bt-soft/nano-wallscout/README.md

# Pulzusindukciós (PI) betonvas-kereső – Arduino Nano + DD tekercs + MCP6004 + IRLZ44N + SSD1306

> [!NOTE]
> A projekt egy kézi impulzusindukciós (PI) elven működő - **mélységbecsléssel ellátott** - betonvas-kereső, amely két D alakú tekerccsel (DD elrendezés) működik. 
>
> Platform: **Arduino Nano (ATmega328P)**.

| Jellemző | Érték |
|---|---|
| Érzékelési mélység* | ≈5–6 cm, 8 cm becsült határeset (Ø8–12 mm betonvas, a tekercsek méretétől függően) |
| Kijelzés | SSD1306 OLED (oszlop, számérték, becsült mélység), hangjelzés |
| Tápellátás | 2S vagy 3S 18650 akkumulátor a Nano VIN bemenetén (lásd: Beüzemelés) |

 *Az értékek a tesztelési körülményektől, a tekercs geometriájától és a beállításoktól függnek.

## Az impulzusindukció működési elve
A kereső két tekercset használ: egy **adó (TX)** és egy **vevő (RX)** tekercset. A [tekercsek D alakúak](https://abl.gtu.edu.tr/dosya/102/~saksoy/Metal%20Detectors/1%20GENERAL%20OVERVIEW/2%20OPERATIONAL%20PRINCIPLES/2.1%20ANTENNAS.pdf), és az egyenes oldalaikkal részben egymásra vannak csúsztatva (DD elrendezés). Az alábbiak a működés fizikai alapjait foglalják össze.

### Az adóimpulzus és a mágneses tér
A Q2 kapcsolótranzisztor bekapcsolásakor az Ltx1 adótekercsre a tápfeszültség kerül, és az árama az induktivitás miatt lineárisan nő: `I ≈ U · t / L`. 12 V-nál, 60 µs-os impulzusnál és 1 mH-s tekercsnél ez elméletileg kb. 0,7 A; a tekercs ellenállása miatt a valós csúcsáram kb. 0,6 A. Az áram körül mágneses tér épül fel, amelynek energiája `E = ½ · L · I²`.

### Kikapcsolás és örvényáramok
A Q2 lezárásakor a mágneses tér gyorsan összeomlik. Ez a tekercsben nagy feszültségtüskét (flyback) okoz, amelyet a D2 és D3 diódák korlátoznak. A gyorsan változó tér a közelében lévő fémtárgyban **örvényáramot** indukál. Az örvényáram saját mágneses teret hoz létre, amely lecsengés közben visszahat a tekercsekre.

- Az örvényáram lecsengésének időállandója függ a tárgy méretétől, vezetőképességétől és mágneses permeabilitásától. A nagyobb, jobban vezető tárgynál a lecsengés hosszabb.
- A tárgy nélküli (levegős) esetben a tekercs saját tranziense gyorsan lecseng, ezért a rövid idő múlva mért jel gyakorlatilag nulla.
- A tárgy jelenléte így a lecsengés „farkában” mérhető többletjelként jelenik meg.

### A DD elrendezés és a közvetlen áthallás kioltása
Az [adó mágneses terének](doc/Fémkereső%20tekercsek%20betonvas%20kereséshez.png) közvetlenül az RX-be jutó része sokszorosan nagyobb lenne a fém jelénél. A két D alakú tekercs átfedésénél azonban a vevőtekercs két felét az adótér ellentétes irányban metszi, ezért a **kölcsönös induktivitás (M) a megfelelő átfedésnél nullára csökken**. A pontos átfedés a beállítási eljárás (DD beállító mód) feladata. A nullpont két oldalán M előjele ellentétes, ezért a beállításkor az előjelváltást kell keresni.

DD-tekercs

Ennek eredményeként fém jelenléte nélkül az RX tekercsre elsősorban a **maradék mágneses áthallás** és a **zaj** jut. Fém jelenlétében a benne indukálódó örvényáramok mágneses tere megváltoztatja a vevőtekercsben mérhető jelet. A megfelelően beállított DD-tekercspár esetén a fém nélküli alapjel alacsony, így a céltárgy által okozott jelváltozás jól érzékelhető.

A nagyobb tekercs megfelelő kialakítás esetén növelheti az érzékelési mélységet, de az elérhető eredmény a tekercsek geometriájától, induktivitásától, ellenállásától, a meghajtóáramtól és a vevő érzékenységétől is függ. A nagyobb tekercs térben kiterjedtebb érzékelési mezőt hozhat létre, ami ugyan növelheti a hatótávolságot, ugyanakkor ronthatja a céltárgy pontos helyének behatárolását.

A projektben alkalmazott, a kisebb 6 × 5 cm-es D alakú tekercspárral az érzékelési mélység körülbelül 5-6 cm. Ez az érték kísérletileg meghatározott (fémcsipeszt közelítve a tekercsek felé), illetve a mérési körülményektől és a céltárgy jellemzőitől függ.

### Jelfeldolgozás
Az Rx jele a mérendő tárgy hatására csak kis amplitúdójú, ezért az MCP6004 két, nem invertáló fokozata (kb. 11 × 11 = 121-szeres erősítés) erősíti, majd az U2D puffer az A0 bemenetre vezeti. A jelszint a Vmid (≈ 2,5 V) körül van, így a jel pozitív és negatív irányban is mérhető.

A mérés **mintavételes**, impulzusonként két ponton:
- **S1**: a kikapcsolás után 60 µs-mal. Ekkor a tárgy örvényárama még jelen van.
- **S2**: a kikapcsolás után 600 µs-mal. Ekkor az örvényáram lecsengett, így ez az alapvonal (offset, drift).

A **jel = S1 − S2**. A különbségképzés kiejti az egyenfeszültségű eltérést és a lassú driftet. 100 impulzus átlagolása a véletlenszerű zajt csökkenti (a zaj nagyjából az átlagolt minták számának négyzetgyökével csökken). A nullázáskor mért, fém nélküli értéket a firmware kivonja, így a megjelenített érték a tárgy hatását mutatja.

### Mélységbecslés
Kis, a tekercstől távoli tárgy esetén az örvényáram jele nagyjából a távolság harmadik hatványával csökken (dipól közelítés): `S ≈ K / d³`. A `K` értéket a kalibrálás határozza meg egy ismert (5 cm) távolságban, innen `d = ∛(K / S)`. Ez a modell a tárgy méretétől és anyagától függ, ezért a kapott érték becslés, nem pontos mérés.

### A fém típusa
Az impulzus utáni jel lecsengésének időbeli jellemzői elvileg információt hordozhatnak a céltárgy anyagáról. A jelenlegi, két időpontban történő mintavételezés és a hozzá tartozó jelfeldolgozás azonban nem biztosít megbízható anyagazonosítást, ezért ezt a funkciót eltávolítottam a firmware-ből.

## Működési ciklus

1. Az IRLZ44N (Q2) 60 µs-ra bekapcsol, a **Tx tekercs** (Ltx1) árama nő.
2. Kikapcsoláskor a flyback-tüskét a D2 (UF4007) és a D3 (ZPY36, 1 W) korlátozza; a névleges **lecsípési szint** nagyjából 37 V.
3. A tranziens lecsengését az Ltx1-gyel párhuzamos R15 + R16 ág (1 kΩ fix ellenállás + 4,7 kΩ-os trimmer) csillapítja. A fémben indukált örvényáram lassabban cseng le; ez a mérendő „farok”.
4. A **külön Rx tekercs** (Lrx1) az Ltx1-gyel DD elrendezésben (részben egymásra csúsztatva) helyezkedik el, így a közvetlen áthallás közel nulla, és az erősítőbe csak a fém által keltett jel jut.
5. A Nano 1 kHz-en ismétel, és impulzusonként két ponton mintavételez az ADC-vel: **S1** a kikapcsolás után 60 µs-mal, **S2** (alapvonal) 600 µs-mal.
6. Jel = S1 − S2, 100 impulzusra átlagolva (kb. 7 Hz kijelzőfrissítés). Ez kiejti az offsetet és a lassú driftet.
7. Indításkor automatikus nullázás történik (a kereső legyen levegőben). Az alapvonal lassan követi a driftet. Egy találat előjelét a firmware megtartja; az ellenkező előjelű kilengést csak 1 másodpercnyi küszöb alatti jel után kezdi új találatként kezelni. Ha a jel kb. 3 másodpercnél tovább állandó marad (pl. nullpont-eltolódás), a firmware lassan újranulláz; egy mozdulatlanul tartott fém így néhány másodperc után elhalkul.
8. A kijelző oszlopot, számértéket és (kalibrálás után) becsült mélységet mutat. A hangjelzés magassága a jellel nő.

### Szoftverműködés – bevezető

A firmware az időkritikus részeken az **AVR hardverregisztereket közvetlenül kezeli** (`PORTD`, `PIND`, `DDRD`, `TCNT1`, `TCCR1/2`, `ADCSRA`, `ADMUX`, `PCMSK2` stb.) az Arduino `digitalWrite`/`analogRead`-jellegű, lassabb és nagyobb kódú burkolófüggvényei helyett. Ez minimalizálja a kód méretét (a program a Nano 30 KB-os flash-ébe fér), és tartja a futási sebességet: a 60 µs-os adóimpulzus, a kikapcsolás utáni S1/S2 mintavétel (0,5 µs-os Timer1-időalap, gyors, 1 MHz-es ADC-órajel) és a hangjelző (Timer2 hardveres kimenet, CPU-terhelés nélkül) így determinisztikus időzítéssel fut.

### Alvó mód (energiatakarékosság)

Ha **5 percig** nincs aktivitás, a műszer a lehető legkisebb fogyasztású **Power-down** módba kapcsol. Aktivitásnak számít: gombnyomás, aktív találat, vagy a nullázás utáni zajküszöböt meghaladó jelváltozás (a zaj nem tartja ébren). Az időkorlát a `config.h` `IDLE_SLEEP_MS` értéke.

Alvás előtt a firmware kikapcsolja a hangjelzőt, az adókaput (az adó nem kap impulzust), az OLED-et (power save, I²C leállítva), az ADC-t és az analóg bemenetek digitális pufferét, a Brown-out detektort és a watchdogot, valamint az összes perifériát (`power_all_disable`).

Ébresztés: a **kalibráló vagy a nullázó gomb** megnyomásával (pin change megszakítás), illetve a tápfeszültség újrakapcsolásával. Ébredés után a készülék újrainicializálódik, megvárja a gomb felengedését (az ébresztő nyomás nem lesz parancs), majd az indításhoz hasonlóan újranulláz – ilyenkor a kereső legyen levegőben.

Megjegyzés: a vevő (erősítő) tápját a firmware nem tudja kapcsolni, mert nincs rá vezérlőláb; az adó viszont impulzus nélkül áramot nem vesz fel. A legkisebb alvóáramhoz a vevő és a kijelző tápja hardveresen is leválasztható egy későbbi fejlesztésben.

### Gombok

Mindkét gomb a D-lábat földre húzza (belső felhúzással). A gombokat a mérés közben is figyeli a firmware, de a művelet a következő kijelzőfrissítéskor (kb. 0,1–0,2 s) hajtódik végre.

**Arduino D5 – NULLÁZÁS / beállító mód**

| Művelet | Normál (kereső) módban | DD beállító módban |
|---|---|---|
| Rövid nyomás (< 1 s), **felengedéskor** lép életbe | Újranullázás: a kijelzőn `Nullazas - legben!`, kb. 15 mérésen át (≈ 2 s) átlagolja a nullpontot és a zajszintet (a küszöb a zajhoz igazodik). Közben a kereső legyen levegőben, és ne legyen jelzés/csipogás. | Kilép a beállító módból, és újranulláz. |
| Hosszú nyomás (≥ 1 s), **még nyomva tartva** lép életbe | Belép a DD beállító módba (a `min` törlődik). | Nincs külön szerepe: a felengedéskor ugyanúgy kilép és újranulláz, mint a rövid nyomás. |

A mód váltását rövid (150 ms-os), 3 kHz-es csipogás jelzi. A hosszú nyomás után a gomb felengedése már nem indít újabb műveletet.

**Arduino D4 – KALIBRÁLÁS / KÖZÉPKERESŐ / `min` törlése**

Normál kereső módban a D4 rövid megnyomásai a következő nézetek között léptetnek: normál keresés → élő `CENTER SCAN` → `Jel-Ido` grafikon → normál keresés. A grafikon folyamatosan gyűjti a méréseket: az amplitúdó jobbról érkezik, a korábbi minták balra gördülnek, így a jel erősségének időbeli alakulása követhető. A grafikon a nullázott jel abszolút értékét mutatja; a szaggatott vízszintes vonal az adaptív küszöb. A hosszú nyomás a távolságtanító képernyőt nyitja meg (lásd lent). DD beállító módban a D4 megnyomása törli a `min` értéket (eddigi legkisebb abszolút áthallás), és újra a következő mérésből indul.

Középkereső módban a kijelző az előjeles, nullázott jelet, annak rövid gördülő grafikonját, a zajküszöböt, az első és a visszapásztázás során mért csúcsot mutatja. A firmware legalább két küszöb feletti mintával jelöltet keres, több csökkenő minta alapján becsül csúcsot, majd visszapásztázás után a két csúcserősséget hasonlítja össze. A `CSUCS MEGEROSITVE` csak ezt a jelerősség-egyezést jelenti: a mintasorszám nem pozíció, így a mód nem mér és nem jelöl ki pontos fizikai középvonalat. A visszapásztázás irányát nem nevezi meg.

A mód bekapcsolásakor a mérő legyen levegőben és fémtől távol. Ha a `ZAJOS MERES` felirat látszik, válassz kevésbé zajos helyet és nullázz újra a D5 rövid megnyomásával. Középkereső módban a driftkövetés és az automatikus újranullázás szünetel, így a hosszan a tekercs alatt tartott tárgyat nem nyomja el a háttérkövetés. A visszalépéshez nyomd meg röviden újra a D4-et.

Normál módban:

1. Tartsd lenyomva a D4-et **1 másodpercig**: megnyílik a `TANITAS 5cm` képernyő, amely folyamatosan mutatja a vett jelet, egy oszlopot és (érvényes kalibráció esetén) a becsült távolságot. A képernyőn a driftkövetés szünetel.
2. Tarts egy vasat (a használt vastípust) pontosan **5 cm**-re a tekercstől, és nyomd meg röviden a D4-et. Ha a jel a küszöb fölött van, a firmware eltárolja a `K = jel · 5³` értéket (az `S ≈ K/d³` modellre), az **EEPROM**-ba menti (kikapcsolás után is megmarad), 3 kHz-es csipogás hallatszik, és 1,5 s-ig `Rogzitve: 5 cm` látszik. A képernyő nyitva marad, így a rögzítés tetszőleges számú alkalommal megismételhető, és a becsült távolság azonnal ellenőrizhető.
3. Ha nincs elég jel, a mentés **nem** történik meg: `Nincs jel!` (vagy túlvezérlésnél `Tulvezerles!`) jelenik meg. Hozd közelebb a vasat, és próbáld újra.
4. Kilépés: a D5 rövid megnyomása (újranullázás nélkül) vagy a D4 ismételt hosszú nyomása.
5. Nullázás közben (`Nullazas - legben!`) a tanítóképernyő nem nyitható meg.

Kalibrálás nélkül a kijelzőn `nincs kal.` látszik, és mélység nem jelenik meg.

Mélység: d = ∛(K/S). Ez a mélység becslése, nem pontos mérés.

### Középkereső paraméterei és ellenőrzése

Az induló értékek a `include/config.h` fájlban vannak; prototípuson, ismert geometriájú célokkal kell őket hangolni.

| Paraméter | Kezdőérték | Szerep |
|---|---:|---|
| `CENTER_CONFIRM_SAMPLES` | 2 | Egymást követő minták a jelölt, illetve a visszatérő emelkedés elfogadásához |
| `CENTER_FALLING_SAMPLES` | 3 | Egymást követő csökkenő minták a lokális csúcs felismeréséhez |
| `CENTER_STAGE_TIMEOUT_MS` | 20000 ms | Csúcskövetési vagy visszapásztázási szakasz maximális ideje; lejáratkor új keresés indul |
| `CENTER_RELEASE_FRACTION` | 0,70 | A küszöb alá eső jel elvetési aránya (hiszterézis) |
| `CENTER_PEAK_HYSTERESIS_FRACTION` | 0,20 | Minimális csúcstól való esés az adaptív zajküszöbhöz képest |
| `CENTER_MIN_RETURN_DROP_FRACTION` | 0,30 | A visszapásztázás előtti völgy minimuma az első csúcshoz viszonyítva |
| `CENTER_RETURN_TOLERANCE_FRACTION` | 0,35 | A két irányban mért csúcserősség megengedett relatív eltérése |
| `CENTER_RETURN_MIN_TOLERANCE` | 2,0 | A csúcsegyezés minimális tűrése a zajküszöb többszörösében |
| `CENTER_NOISY_THRESHOLD` | 8,0 | Ezen adaptív küszöb felett zajos mérés figyelmeztetés |
| `SIGNAL_TIME_GRAPH_SIZE` | 32 | A Jel-Ido grafikon rögzített mintaszáma |

Kalibráláskor a kereső legyen levegőben, fémtől távol és a végleges mechanikai elrendezésben. Fém nélküli stabil, majd zajos környezetben ellenőrizd a soros `noise_th` értéket; a `CENTER_NOISY_THRESHOLD`-öt és a többi értéket csak ilyen mérések után módosítsd. Ezután tesztelj több ismert átmérőjű és mélységű betonvassal, mindkét pásztázási irányban és különböző kézi sebességgel. Jegyezd fel a megismételt csúcsok eltérését, a téves találatokat és a fel nem ismert célokat.

Elfogadási próbák: fém nélküli stabil/zajos mérés; egyetlen széles csúcs oda-vissza pásztázása; egyetlen rövid küszöb feletti tüske; változó és többcsúcsú jel; két közeli fémtárgy; lassú nullpontvándorlás; gyenge vagy hatótávon túli cél; hosszan egy helyben tartott cél; nullázás vagy DD-mód váltása középkeresés közben. A visszatérő csúcs nem erősíthető meg egyetlen tüskéből: a logikának a völgy után két egymást követő emelkedő mintát, majd több csökkenő mintát és a csúcserősségek egyezését igényli. Ezek szoftveres feltételek, nem garantálják a betonvas tényleges geometriai középvonalát.

### Soros monitor (115200 baud)

> [!WARNING]
> Ha a fordítás során a [__DEBUG__](https://github.com/bt-soft/nano-wallscout/blob/main/src/main.cpp#L12) makró definiálva van, az AVR debugger 
> aktiválódik. Ha emellett a [__DEBUG_SERIAL_LOGGING__](https://github.com/bt-soft/nano-wallscout/blob/main/src/main.cpp#L13) makró is definiálva 
> van, az Arduino soros portján keresztüli naplózás aktiválódik, az AVR debugger viszont nem. 
> **A két funkció egyidejűleg nem használható.**

Minden mérés (kb. 0,1–0,2 s) után egy sor jelenik meg, pl. `run diff=3.20 raw_diff=3.20 s1=512 s2=510 idle=511 zero=0.40 sig=2.80 vbat=11.8`. Az elején `run` (kereső), `center` (középkereső) vagy `setup ch=A0` (DD beállító mód) áll. Középkereső módban a `center_sig`, `noise_th`, `center_state`, `peak`, `return_peak`, `peak_sample` és `return_sample` mezők is megjelennek. A mintasorszám diagnosztikai adat, nem fizikai távolság. Az értékek ADC-egységben (0–1023) vannak, 100 impulzusra átlagolva.

| Mező | Jelentés |
|---|---|
| `s1` | Az első mintavétel átlaga az A0 bemeneten: a Tx kikapcsolása után 60 µs-mal (`T_SAMPLE1`). Ebben van a fém örvényáramának lecsengő jele. Nyugalmi értéke ≈ 512 (Vmid). 950 fölött vagy 70 alatt az erősítő telít, ekkor `TULVEZERLES`. |
| `s2` | Referencia (alapvonal) mintavétel átlaga: a kikapcsolás után 600 µs-mal (`T_SAMPLE2`), amikorra az örvényáram már lecsengett. Nyugalmi értéke szintén ≈ 512. |
| `raw_diff` | Az aktuális `s1 − s2` különbség simítás nélkül. A visszaállás ellenőrzése ezt és a nyers `s1`, `s2` értékeket használja. |
| `diff` | `s1 − s2`, előjeles, simítva (exponenciális átlag: normál módban 0,5, beállító módban 0,1 súllyal; 60-nál nagyobb ugrásnál újraindul). Ez a nullázatlan jel. DD beállító módban ez látszik a kijelzőn. |
| `idle` | DC-ellenőrzés: az A0 értéke impulzus nélkül, 3 ms-mal a mérés után (8 minta átlaga). Nyugalmi értéke ≈ 512. Ha 900 fölött vagy 120 alatt van, a bemenet DC-szintje hibás, a kijelzőn `DC HIBA!` jelenik meg. |
| `zero` | A nullpont: induláskor a levegőben mért 15 `diff` átlagából indul. Keresés közben csak a detektálási küszöb alatti, nem találatként kezelt jelnél követi lassan a driftet. Találatkor befagy; tartós, állandó jel nem nullázódik újra automatikusan. |
| `sig` | A nullázott jel: `diff − zero`. A kijelzőn ennek abszolút értéke látszik, ez adja az oszlopot, a csipogó hangját és a mélységbecslést (`d = ∛(K/\|sig\|)`). Nullázás és beállító mód alatt 0. |
| `vbat` | Akkufeszültség (V), a belső 1,1 V-os referenciával korrigálva. |

Találat után a firmware megtartja a jel előjelét, és az ellenkező irányú átmeneti kilengést nem indítja új találatként. A visszaállás csak akkor fejeződik be, ha nyolc egymást követő mérésben a nyers `s1`, `s2` és `s1 − s2` értékek visszatértek az eltárolt alapvonal közelébe. Ekkor a nullpont és a szűrőállapot együtt, az ellenőrzött mérésekből áll be újra. Túlvezérlés vagy DC-hiba alatt ez a visszaállás nem fogadható el.

### Miért elég a Nano?

A 10 bites, 5 V-os ADC lépése ≈ 4,9 mV. A két erősítőfokozat névleges, összesített erősítése kb. ×121, így ez az Rx-nél ≈ 40 µV/LSB. A 100 impulzus átlagolása az ADC saját zajával együtt 0,1 LSB alá viszi a felbontást, ami a Pico valós (kb. 9 bites, 3,3 V-os) felbontásával egyenértékű. A mintavételi időzítést a Timer1 (0,5 µs) adja, az impulzus közben a megszakítások tiltva vannak.

## DD tekercsek

A projektet kifejezetten betonvasak felderítésére terveztem, ezért kezdetben a kisebb tekercsekkel kísérleteztem. Ezek elméleti érzékelési mélysége körülbelül 8 cm, ez azonban erősen becsült, idealizált érték, amely a tényleges mérési körülményektől is jelentősen függ.

A kisebb tekercsméret korlátozhatja az érzékelési mélységet, ezért egy [nagyobb tekercspártól](doc/tekercs-sablon-nagy.svg) potenciálisan nagyobb hatótávolság várható. Ezt elsősorban a tekercsek geometriája, a meghajtóáram, a működési frekvencia és a vevő érzékenysége határozza meg. Fontos azonban, hogy a tekercs lineáris méretének 2,5-szeres növelése nem eredményez automatikusan ugyanilyen arányú növekedést az érzékelési mélységben.

A projektet nagyobb tekercsekkel egyelőre nem teszteltem, így az ezekkel elérhető hatótávolság kísérleti úton igazolandó. A kipróbáláshoz kiindulási pontként a nagy sablonhoz egy 60 menetes, 0,3 mm átmérőjű CuZ huzalból készült tekercspárt javaslok.

Az alábbi adatok a [kisebb sablonra](doc/tekercs-sablon-kicsi.svg) vonatkoznak.

| Paraméter | Érték |
|---|---|
| Tekercsek | 2 db D-tekercs, egyenként 1 mH, 6 cm egyenes oldal, 5 cm D-mélység, 80 menet, Ø0,3 mm CuZ |
| Szerep | Ltx1 = Tx (adó), Lrx1 = Rx (vevő) |
| Elrendezés | az egyenes oldalaikkal részben egymásra csúsztatva (DD) |
| Csúcsáram (12 V / 60 µs) | ≈ 0,6 A (9 V-nál ≈ 0,45 A), a tekercs R-jétől függően |

**Mérd meg az induktivitást (L) és az egyenáramú ellenállást (R).** Ha az ellenállás 6 Ω fölött van, a csúcsáram jelentősen csökken. Az átfedést a DD beállító móddal keresd meg, majd rögzítsd. A két tekercs síkja azonos legyen. A vezérlőig rövid, sodrott, árnyékolt vezetéket használj.

### A tekercsek elkészítése
Két azonos tekercs szükséges: **80 menet, 0,3 mm-es zománcozott rézhuzal (CuZ)**, D alakú, **60 mm egyenes oldallal és 50 mm mélységgel** (a huzal középvonalán mérve). Az 1:1 méretarányú, nyomtatható sablon: [kis tekercssablon](doc/tekercs-sablon-kicsi.svg) (100%-os méretben nyomtasd). A vevőtekercset alufóliával és földvezetékkel árnyékold a kapacitív csatolás ellen.

#### Lépések
0. Készítsd el a tekercs vázát a sablon alapján! Az 1:1 méretarányban kinyomtatott sablont rögzítsd egy rétegelt lemezre. A sablonon jelölt furatok helyét Ø1,5 mm-es fúrószárral [fúrd át a lemezbe](doc/Tekercs-váz-1.jpg). Ezután vágj félbe néhány fogpiszkálót, majd a hegyes végüket ragasztóba mártva illeszd őket a furatokba. Ügyelj arra, hogy a [fogpiszkálók](doc/Tekercs-váz-2.jpg) stabilan álljanak, mert ezek fogják vezetni és megtartani a tekercs huzalát.
1. Tekerj **80 menetet** szorosan, szabálytalanul (nem kell egyvonalban) egymás mellé a sablon hornyaiba illesztett [csapok](doc/tekercs-1-Sablonra.jpg) köré. Mindkét végén hagyj kb. 30 cm-es kivezetést.
2. [Kösd át a tekercset ideiglenesen](doc/tekercs-2-Átmeneti_bandázs.jpg) pl. vékony maszkolószalag-csíkkal **több helyen**, hogy a köteg együtt maradjon.
3. A csapokról [emeld le a köteget](doc/tekercs-3-Sablonról_leszedve.jpg). Az alak már D, külön hajlítani nem kell.
4. Az ideiglenes kötéseket fokozatosan eltávolítva [tekerd körbe a tekercset pl. teflonszalaggal](doc/tekercs-4-TeflonSzalag.jpg).
5. Mérd meg az induktivitást. A várt érték kb. **1 mH**. (A méréshez saját [induktivitásmérőt](https://github.com/bt-soft/nano-inductance-meter) készítettem.)

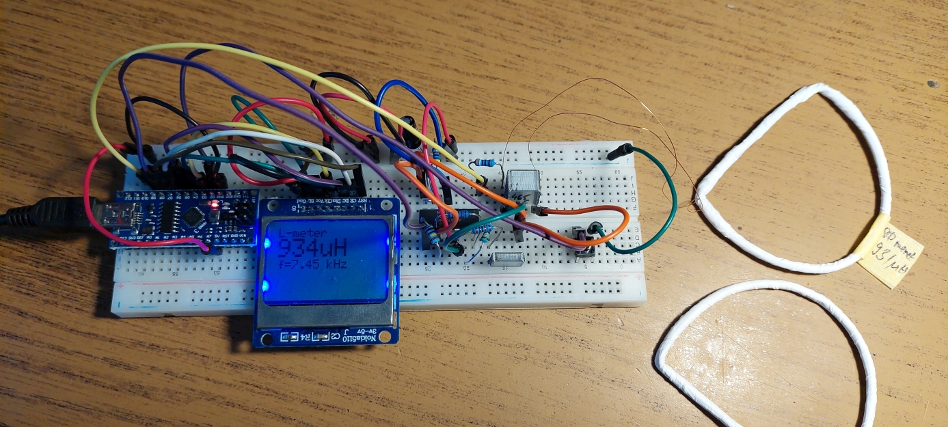
[picture p1: doc/tekercs-6-L_mérés.jpg]


6. A vevőtekercset mindenképpen árnyékold (az adót, ha nem vagy rest). Szigetelésmentes, vékony rézdróttal tekerd körbe a köteget úgy, hogy **ne alkosson záródó vezetőhurkot**, azaz a vége ne érjen az elejéhez. Erre vékony csíkokra vágott [alufóliát tekerj](doc/tekercs-5-1-Árnyékolás.jpg); az alufólia a szigeteletlen rézdróttal érintkezve **leföldelhető**. Az alufólia **szintén ne alkosson zárt hurkot**: hagyj [rést az árnyékoláson](doc/tekercs-5-2-Árnyékolás_hézag.jpg).
7. A DD átfedés behangolása után a tekercseket **merev, fém- és ferritmentes vázra** (fa, műanyag, textolit) rögzítsd. A behangolás igen érzékeny, ezért a tekercsek helyzete rögzítés után nem változhat.

### A tekercsek kivezetéseinek polaritása

A tekercsek kivezetéseinek (az Rx vagy a Tx két végének) felcserélésére **nem kell ügyelni**.

- A felcserélés csak 180°-kal fordítja az Rx-jelet: az S1 − S2 előjele megváltozik, a nagysága nem.
- Az áthallás nullpontja (az átfedés, ahol a közvetlen áthallás eltűnik) ettől nem tűnik el. Az áthallás előjele az átfedés két oldalán amúgy is ellentétes, és a DD-beállító mód az abszolút értékre keres minimumot.
- A detektálás, a küszöb, a hangjelzés, a középkereső és a mélységbecslés a jel nagyságát használja. Az előjelet a firmware csak a találat lezárásához tartja meg, és ez fordított előjelnél is ugyanúgy működik.
- A Tx árama a meghajtó MOSFET-től és a flyback-diódától függ, ezért nem a tekercs bekötési irányától.
- Impulzusos (PI) működésnél az Rx csak a lecsengő tranzienst látja, folytonos adó-vevő fázis nincs, ezért fázismérésre sincs szükség.

**Mi számít valódi hibának?**

- Az áthallás semmilyen átfedésnél sem megy nullára: ez geometriai, elhelyezési vagy árnyékolási hiba, nem polaritáshiba.
- Az árnyékolás vagy a leföldelés zárt vezetőhurkot alkot (lásd a 6. lépést).
- Az egyik tekercs menetei tekercselési hiba miatt részben ellentétes irányban futnak; ezt a kivezetések cseréje nem pótolja.
- A tekercsek fém- vagy ferrittartalmú vázra vannak rögzítve, vagy a rögzítés után elmozdulnak.

### DD átfedés beállítása (firmware-es segítség a beállításhoz)

Az átfedés beállítása időigényes: a mágneses csatolás a kritikus átfedés közelében igen élesen változik, ezért türelmet és ismételt finombeállítást igényel. A behangolt tekercseket ezután stabilan rögzíteni kell, mert később nem mozdulhatnak el.

1. A tekercsek legyenek fémtől távol.
2. Tartsd lenyomva az **Arduino D5-re kötött NULLÁZÁS** gombot 1 másodpercig: a kijelzőn `DD beallitas` jelenik meg.
3. A kereső és a DD beállító mód is az **A0** bemenetet használja, az U2D bufferelt kimenetéről. A jelút két nem invertáló fokozata (U2A: R11 = 100 kΩ / R12 = 10 kΩ, U2B: R8 = 100 kΩ / R9 = 10 kΩ) névlegesen kb. 11 × 11 = 121-szeres erősítést ad; a fokozatok között R10 (1 kΩ) van. U2D követőként puffereli a jelet, az R5 (390 Ω) pedig soros ellenállás az A0 felé. A [kijelzőn a közvetlen áthallás látszik](doc/DD-hangolás-2.jpg) **előjelesen** (S1 − S2), alatta külön sorban a `min` (az eddigi legkisebb abszolút érték) és a nyers `S1` (nyugalmi értéke ≈ 512), legalul középre nullázott logaritmikus oszlop. A csipogó annál magasabb, minél nagyobb az áthallás, és elhallgat, ha az érték 1,5 alá esik (`NULL OK`).
4. Csúsztasd az egyik tekercset a másikhoz képest. Az érték **előjelet vált**, ezen a ponton kell a minimumot keresni. A kezdeti átfedés a D egyenes oldalának néhány mm–1,5 cm-e.
5. Ha megvan, rögzítsd a tekercseket, és nyomd meg röviden a gombot: a kereső kilép a módból, és újranulláz.

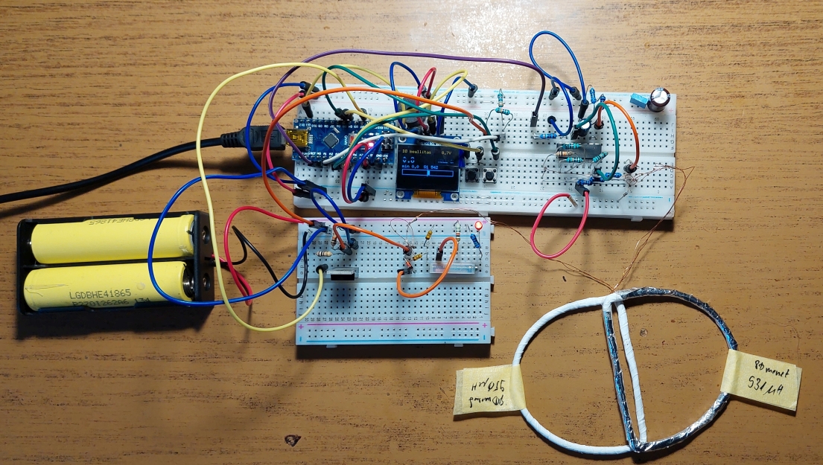
[picture p2: doc/DD-hangolás-1.jpg]


Ha az erősítő telítésbe megy (az S1 a 0 vagy 1023 közelében), a fejléc `TULVEZERLES`-re vált, a szám az S1 eltérése 512-től (az előjel megmutatja, merre telít), a csipogó mély, folyamatos hangot ad, és a `min` **nem frissül**. A telítés tehát nem számít jó minimumnak. Addig csúsztasd a tekercset, amíg a `TULVEZERLES` el nem tűnik, és az `S1` 512 körül van.

## Kapcsolási rajz
A kapcsolási rajz és a NYÁK két változatban is elérhető: Arduino Nano modullal, illetve közvetlenül az ATmega328P mikrovezérlő használatával, azok számára, akik nem modult szeretnének használni.

### Arduino Nano
KiCad-séma

### Atmel328P 
KiCad-séma

Az Atmel328P mikrovezérlós verzióhoz NYÁK terv is készült
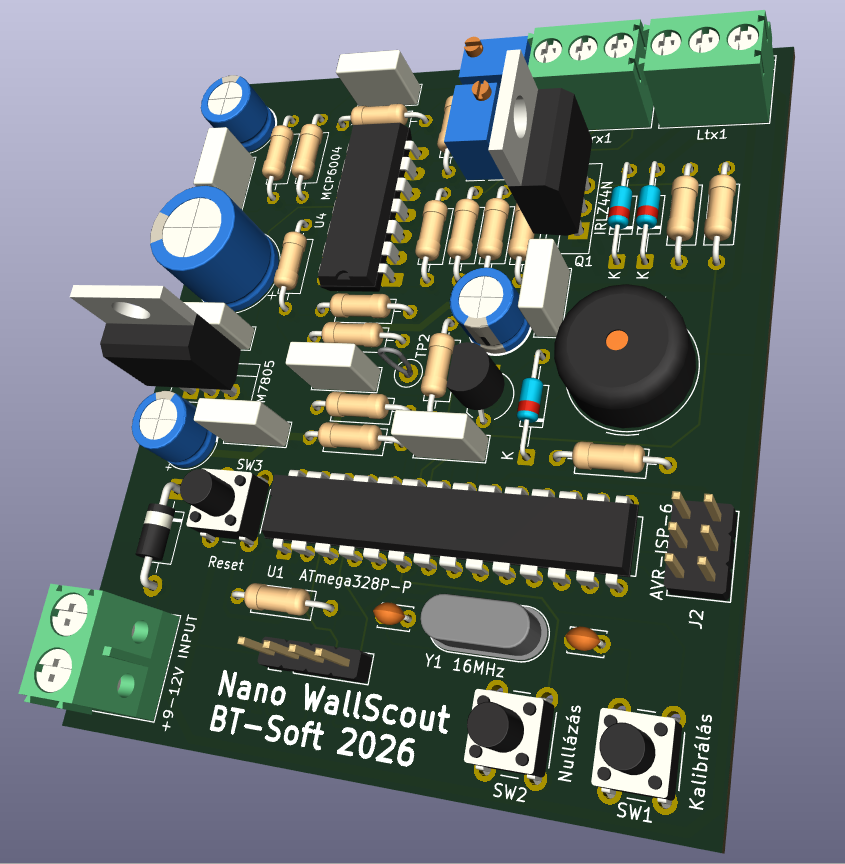
[picture p3: kicad/nano-wallscout-Atmega328P/nano-wallscout-Atmega328P-3D.png]
KiCad-NYÁK


### Védelem

#### Flyback-védelem

Q2 kikapcsolásakor a tekercs árama nem tud azonnal megszűnni, ezért flyback-feszültség keletkezik. A lecsípő ág D2 (UF4007) és D3 (ZPY36, 1 W) soros kapcsolata; a lecsípés névleges szintje a zenerfeszültség és a D2 nyitófeszültségének összege. A Q2 IRLZ44N adatlap szerinti VDS-határa 55 V, ezért a `T_ON` növelése előtt szkóppal ellenőrizd, hogy a drain csúcsa **50 V alatt** marad.

lecsípés magyarázata

Az Rx bemeneténél az R13 = 10 kΩ soros ellenállást mutat az U2A bemenete előtt; az Lrx1-gyel párhuzamosan (a Vmid felé) az R14 (2,2 kΩ-os trimmer) csillapít. A Vmid osztót R6 (felső) és R7 (alsó) alkotja, egyenként 100 kΩ.

## Főbb alkatrészek listája

| Db | Alkatrész |
|---|---|
| 1 | Arduino Nano (vagy ATmega328P + 16Mhz kvarc) |
| 1 | MCP6004  |
| 1 | IRLZ44N – Tx kapcsoló |
| 1 | 2N2222 – buzzer-meghajtó |
| 1 | SSD1306 I²C OLED  |
| 2 | 1 mH-es D-tekercs: Ltx1 (Tx) és Lrx1 (Rx) |
| 1 | UF4007 , 1 db ZPY36 / 1 W zener , 1 db 1N4148 (a buzzer fordított diódája) |
| 1 | Buzzer (BZ1, 15 Ω) |
| 2 | nyomógomb: SW1 (kalibrálás), SW2 (nullázás) |
| – | Ellenállások, Kondenzátorok |

## Beüzemelés

1. Első bekapcsoláskor áramkorlátos tápról ellenőrizd a tápot. A külső táp a `+BATT` bemenetre kerül, a Nano saját VIN bemenetén keresztül; külön L7805 nincs a kapcsolásban. Ellenőrizd, hogy a Nano 5 V-os sínjén a modulnak megfelelő tápfeszültség van.
2. A firmware-ben kezdetben `T_ON = 60 µs`; első próbánál csökkentsd ezt az `config.h`-ban, és csak kis áramkorlát mellett tesztelj.
   - **Drain-mérés:** szkóppal (10×-es szonda, rövid földelés) nézd a Q2 drainjét. Flyback csak induktív terheléssel van, ezért ehhez a méréshez kösd be az Ltx1-et, az Rx jelút maradhat üresen. Arduino D2 hajtja Q2 kapuját az R17 (100 Ω) soros ellenálláson át; R18 (10 kΩ) tartja alacsonyan a kaput.
   - **Elvárás:** D2 és D3 névleges értéke alapján a lecsípés nagyjából 37 V körül várható, de az impulzusáram és a parazita induktivitás módosíthatja a csúcsot. A Q2 drainjén mért csúcs maradjon **50 V alatt** (Q2 VDS,max = 55 V). Ha magasabb, ne növeld a `T_ON`-t; ellenőrizd D2, D3 és a bekötést.
   - **Hiba esetén:** ha a gate nem billen, ellenőrizd az Arduino D2 jelet, az R17/R18 ellenállásokat és a bekötést. Ha Q2 vagy D2 melegszik, azonnal kapcsold le.
3. Kösd be az Ltx1-et, és állítsd be a csillapítást:
   - **Mi ez:** az R15 (1 kΩ) és az R16 (4,7 kΩ-os trimmer) soros ága az Ltx1-gyel párhuzamos. Kikapcsoláskor a tekercs és a parazita kapacitások rezgőkört alkotnak; az R16 beállításával hangolható a csillapítás.
   - **Mérés:** szkóppal a Q2 **drainjén** nézd a kikapcsolás utáni lecsengést (10×-es szonda, a földcsipesz a lehető legrövidebben a Q2 source-ához). Triggerelj a gate lefutó élére, az időalap 5–10 µs/osztás legyen. Közben a csúcs maradjon **50 V alatt**.
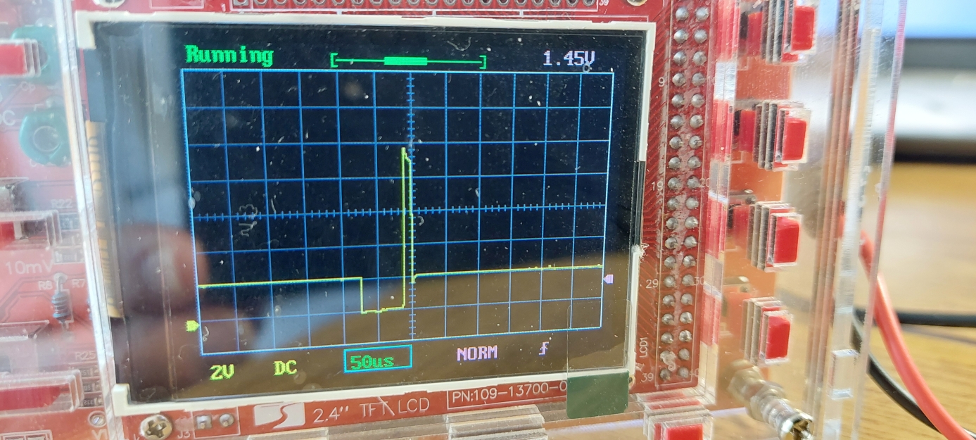
[picture p4: doc/Tüske_szkóp.jpg]
   
   Jó csillapítás a drain-en
   - **Beállítás:** az R16 trimmert a legnagyobb ellenállás felől indulva állítsd, amíg a jel a lehető leggyorsabban, **túllövés és visszarezgés nélkül** éri el az alapszintet.
     - Túl nagy csillapítóellenállás (R15 + R16): alulcsillapított, a jel az alapvonal körül **rezeg**, a lecsengés elhúzódik.
     - Túl kis csillapítóellenállás: túlcsillapított, a jel nem rezeg, de **lassan közelít** az alapszinthez, és a tekercs árama is jobban terheli az ellenállást.
   - **Elvárás:** a tekercs és a szerelés miatt a pontos beállítást szkóppal kell ellenőrizni. Ha a jel lecsengése nem fejeződik be a mintavételig, a `T_SAMPLE1` növelése szükséges (lásd az 5. pontot).
4. Kösd be az Lrx1-et, és ellenőrizd az analóg jelutat. Az R13 (10 kΩ) az U2A bemenete elé kerül, az Lrx1-gyel párhuzamosan az R14 (2,2 kΩ-os trimmer) csillapít; R5 (390 Ω) az U2D kimenete és az Arduino A0 között van, nem trimmer. A Vmid-et az R6/R7 (egyenként 100 kΩ) osztó, a C4 és az U2C puffer állítja elő; a rajz nem tartalmaz külön Rx-védődiódát.
   - **Nyugalmi szint:** a tekercsek levegőben, fémtől távol az A0 nyugalmi értéke kb. **2,5 V** legyen. A soros monitoron `s1` ≈ 512 és `s2` ≈ 512. Ha ez jelentősen eltér, ellenőrizd a Vmid-et, a tápot és az MCP6004 bekötését.
   - **Mérés:** szkóppal az **U2A kimenetén (1. láb)**, az U2B kimenetén (7. láb) és az U2D kimenetén (14. láb) ellenőrizd a lecsengést a Tx kikapcsolása után. Triggerelj a gate lefutó élére, és tarts egy vasat a tekercshez, hogy a lecsengés látszódjon. Az U2A/U2B fokozatokat, valamint az U2D puffert lásd a kapcsolási rajzon.
   Rx jelalakok
5. A DD beállító móddal állítsd az átfedést minimális áthallásra (lásd fent), és rögzítsd.
6. Nézd meg az U2A kimenetén (1. láb), mikor ér vissza a jel az alapszintre. Ha 60 µs-nál később, a `T_SAMPLE1`-et növeld ([config.h](include/config.h)).
7. Tarts egy vasat a tekercshez: a jel nőjön. Az `abs()` miatt a polaritás nem számít, de a soros monitoron (`sig`) látod.
8. Ha telít (`TULVEZERLES`), javítsd az átfedést. Az erősítő ellenállásait ne módosítsd találomra; az értékeket a kapcsolási rajz rögzíti.
9. Kalibrálás 5 cm-nél, majd ellenőrzés 6 és 8 cm-nél.

## A kütyü felélesztése – lépésről lépésre

Ez a rövid útmutató a [Beüzemelés](#beüzemelés) fejezet sorrendjét követi, kiegészítve azzal, hogy mit hol mérj, és mit kell látnod. Mindig áramkorlátos tápról, először tekercsek nélkül kezdj.

### 1. Táp és vezérlés (tekercsek nélkül)

1. **Táp:** a `+BATT` bemenetre áramkorlátos táp (kezdetben ~100 mA), a Nano 5 V-os sínjén 5 V legyen. Az USB-t csak programozáshoz használd.
2. **Firmware:** `pio run -t upload`. Indulás után az OLED-en a `Nullazas - legben!` felirat látszik kb. 2 s-ig, utána a normál kereső nézet.
3. **Kapu (D2 → Q2 gate):** szkóppal a Q2 gate-en **60 µs** széles, 0–5 V-os impulzusok legyenek 1 ms periódussal (R17 = 100 Ω soros, R18 = 10 kΩ lehúzó). Az impulzusok **nem folyamatosak**: egy mérés 100 impulzusból álló csomag (~100 ms), utána szünet jön (kiértékelés, kijelző, DC-ellenőrzés), ezalatt a gate alacsony. Triggerelj a gate felfutó élére; a csomagszerkezet kb. 20–50 ms/osztással látszik. Ha nincs jel, nézd a D2 lábat és a bekötést.

   Gate csomagszerkezet
4. **Akku:** a soros monitoron (115200 baud) a `vbat` a valós tápfeszültséget mutassa.

### 2. Adóág (Ltx1)

1. Kösd be az Ltx1-et, a vevőt (Lrx1) még ne.
2. **Mérés:** a Q2 **drainjén** (10×-es szonda, rövid földcsipesz a source-nál), trigger a gate lefutó élére, 5–10 µs/osztás.
3. **Elvárt jel:** a bekapcsolás alatt a drain ~0 V, kikapcsoláskor flyback-tüske, amelyet a D2 + D3 ~37 V-ra lecsíp. A csúcs **50 V alatt** maradjon (Q2 VDS,max = 55 V).
4. **Csillapítás:** az R16 trimmerrel (R15 + R16 a tekerccsel párhuzamosan) állítsd be, hogy a jel a legrövidebb idő alatt, **túllövés és visszarezgés nélkül** érje el az alapszintet. Ha melegszik a Q2 vagy a D2, azonnal kapcsold le.

### 3. Vevőegység (Rx jelút) felélesztése

1. Kösd be az Lrx1-et (R13 = 10 kΩ soros, R14 = 2,2 kΩ trimmer párhuzamosan), a tekercsek legyenek levegőben, fémtől távol.
2. **Egyenszintek (multiméter):** a Vmid (R6/R7 osztó, C4, U2C puffer) ≈ **2,5 V**; az U2D kimenete (14. láb) és az **A0** is ≈ 2,5 V.
3. **Soros monitor:** `s1 ≈ 512`, `s2 ≈ 512`, `idle ≈ 511`, `diff` és `sig` a nulla körül ingadozik (néhány egység). Ha `idle` 900 fölé vagy 120 alá megy, a kijelzőn `DC HIBA!` látszik: ellenőrizd a Vmid-et, a tápot és az MCP6004 bekötését.
4. **Szkóp (trigger a gate lefutó élére), a Tx kikapcsolása után:**
   - U2A kimenet (1. láb), U2B kimenet (7. láb), U2D kimenet (14. láb): a kezdeti tranziens után a jel az alapszintre (~2,5 V) csenged le. A két fokozat névleges erősítése ~11 × 11 ≈ 121.
   - Tarts egy vasat a tekercshez: a lecsengés „farka” megemelkedik, a soros monitoron az `s1` eltér az `s2`-től, a `sig` nő, a kijelzőn az oszlop és a hang is emelkedik (az előjel nem számít).
5. **Mintavételi idő:** ha az U2A kimenete 60 µs-nál később ér vissza az alapszintre, növeld a `T_SAMPLE1` értékét a [config.h](include/config.h)-ban. Az `s1` 950 fölött vagy 70 alatt telít (`TULVEZERLES`), ilyenkor ellenőrizd az áthallást (DD átfedés), ne az erősítést módosítsd.

### 4. A DD nullpont (minimális áthallás) megkeresése

1. A tekercsek fémtől távol, a hangolás idejére lazán rögzítve, egymáson csúsztathatóan.
2. D5 hosszan (≥ 1 s): a kijelzőn `DD beallitas`. A mód az A0-t méri; kijelzőn és soros monitoron (`setup ch=A0`) az előjeles áthallás (`S1 − S2`), a `min` (eddigi legkisebb abszolút érték) és az `S1` (≈ 512) látszik, alul a logaritmikus oszlop.
3. Csúsztasd az egyik tekercset a másikhoz képest, a D egyenes oldalainak néhány mm – 1,5 cm-es átfedése körül. Az érték az átfedés két oldalán **előjelet vált**: a nullpont ott van, ahol átbillen.
4. Finomítsd, amíg a csipogó elhallgat és `NULL OK` látszik (az érték < 1,5). Ha `TULVEZERLES` jelenik meg, az S1 telít, és a `min` nem frissül; csúsztasd tovább, amíg el nem tűnik. A D4 törli a `min` értéket.
5. Rögzítsd a tekercseket úgy, hogy később ne mozdulhassanak, majd D5 rövid nyomás: kilép a módból és újranulláz.
6. Ellenőrzés: normál módban levegőben `sig` ≈ 0, a háttérzaj kicsi, a küszöb (`runTh`) alacsony.

### 5. Tanítás (kalibrálás) – mélységbecsléshez

1. Nullázás után (kereső levegőben) tartsd a D4-et **1 s-ig**: `TANITAS 5cm` képernyő.
2. Tarts egy vasat (a használt vastípust) pontosan **5 cm**-re a tekercstől, majd röviden nyomd meg a D4-et.
3. Siker: 3 kHz-es csipogás és `Rogzitve: 5 cm`; a `K = jel · 5³` az EEPROM-ba kerül. `Nincs jel!` esetén közelebb kell vinni a vasat, `Tulvezerles!` esetén távolabb. Tetszőleges számú alkalommal megismételhető.
4. Kilépés: D5 rövid nyomás vagy D4 hosszú nyomás. Ellenőrzés 6 és 8 cm-nél: a becsült távolság (d = ∛(K/S)) hozzávetőlegesen egyezzen. Kalibráció nélkül `nincs kal.` látszik.

Akkucsere vagy hőmérséklet-változás után nullázz újra (D5 rövid nyomás). Ha a jel stabilan zajos, nézd az `idle` és `vbat` mezőket, valamint a buzzer tápágának szűrését.

## A prototípus próbája
A prototípus jól viszonylag jól teljesített, bár vannak betonfalak, ahol mindenhol (a teljes felületen) jelez, aminek az okát még nem egészen értem (belső, nem teherhordó betonvas válaszfal...).
Az viszont jól látszik, hogy a stabilitás és a kényelmesebb használhatóság miatt kell neki egy NYÁK. Az érzékenységen a kb 1m-es árnyékolt vezetékek ugyan észrevehetően nem rontanak, de nem a földben szeretnék kincseket keresni, hanem a betonfúró száraimat megóvni, így egy kompakt egy kézben használható kiépítés szükséges.
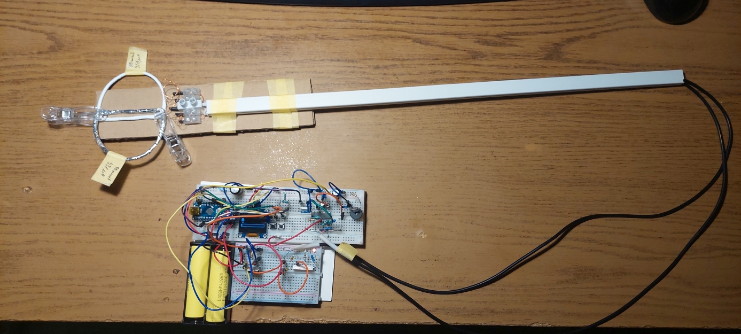
[picture p5: doc/prototípus.jpg]
prototípus


A D-D tekercsek beállítása bár pontosan megoldható, de a rögzítésük azért hagy némi kívánnivalót...
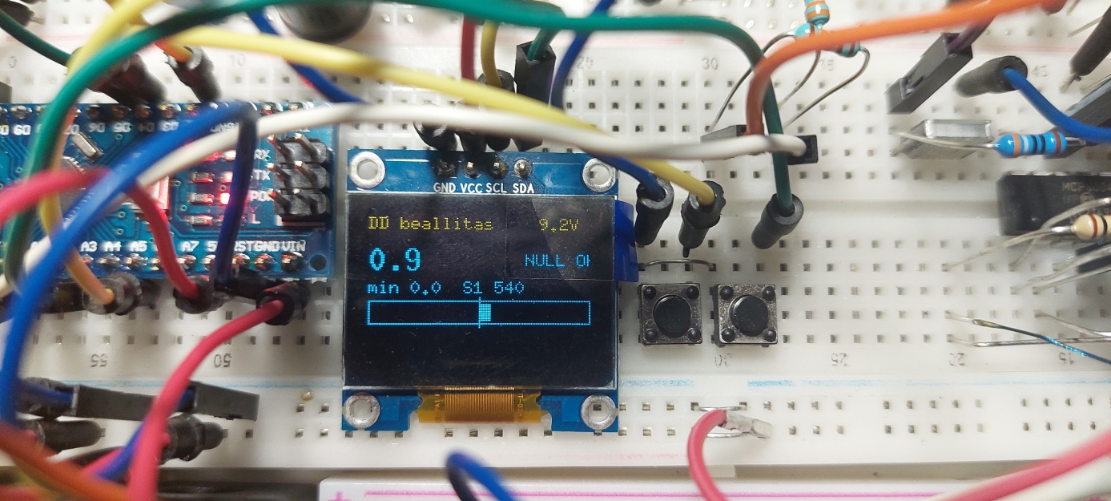
[picture p6: doc/DD-beállítás.jpg]


Mindenesetre működni látszik a kütyü: a falon való tesztkeresés némi rendszerességet mutat, egyelőre csak a függőleges vasakat deritettem fel, kb 53cm-enként van egy erősebb jelzés... Bár sosem láttam egy belső teherhordó betonfal vasalását, de elhiszem, hogy ilyen lehet.

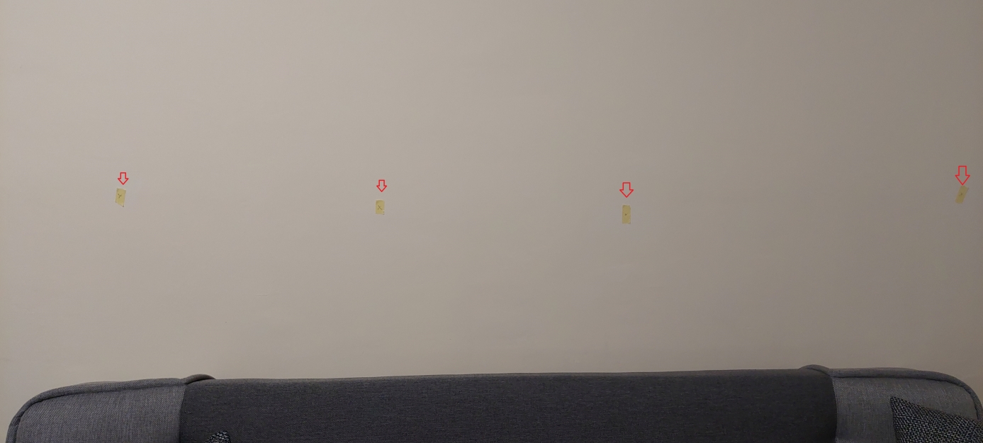
[picture p7: doc/fal-scanning.jpg]
próba scanning


## Ismert korlátok/kockázatok

- Az MCP6004 (1 MHz GBW) túlvezérlés utáni felépülése lassú lehet. Az R13 bemeneti soros ellenállás nem helyettesíti a külön védődiódát; a mintavételi késleltetést mérés alapján állítsd be.
- A kis tekercsek (≈ 6 × 5 cm) miatt a 8 cm határeset, főleg vékonyabb vasnál és betonban.
- A számértékek (`DETECT_TH`, `FULL_SCALE`, `T_SAMPLE1`) számított, javasolt értékek; a prototípuson hangolni kell őket.
- Az akku/tekercsáram tápingadozása az alapvonalba megy, akkucsere után nullázz újra.
- A 3S akku feszültségét a Nano VIN bemenetére kapcsolt táp és a modul saját feszültségszabályozója határozza meg; a melegedést és a megengedett bemeneti feszültséget az alkalmazott Nano-modul adatlapja szerint ellenőrizd.
- A watchdog (1 s) lefagyás esetén újraindítja a Nanót; a 10 kΩ lehúzó (R18) addig is alacsonyan tartja a kaput. A régi (57600 baudos) bootloaderes Nanók watchdog-reset után megállhatnak; ilyenkor kapcsold ki és be a tápot, vagy állítsd a `USE_WATCHDOG` értékét 0-ra.
- A 15 Ω-os buzzert a Q1 (2N2222) kapcsolja: D11 → R2 (1 kΩ) → bázis; a buzzer az R1 (150 Ω) soros ellenálláson át a +5 V-ról kap áramot, a D1 (1N4148) fordított dióda. A buzzer árama a +5 V-on és a földön át az analóg mérőkörbe is bejuthat, ezért az alapvonal a csipogás alatt elmozdulhat. Ezt a csipogó külön tápágának szűrésével (soros ellenállás + elko) és külön földvezetékkel lehet csökkenteni.

## Fordítás

```
pio run                      # régi bootloaderes Nano (nano környezet)
pio run -e nano_newboot      # új (115200 baudos) bootloader
pio run -t upload            # feltöltés
```
> [!WARNING]
> Nano esetén az USB-t csak a programozáshoz használd!
> Az USB bár képes meghajtani az adókört, de feleslegesen terheli azt. 
> A kapcsolás csak a Nano USB-visszatáplálást gátló diódáját használja; a külső táp és az USB egyidejű használatánál vedd figyelembe a használt [Nano-modul tápáramkörét.](https://europe1.discourse-cdn.com/arduino/original/4X/3/1/4/3149e64bf4e90a746684c5a5d9e10b392fd5081a.jpeg)
