bt-soft/nano-wallscout/doc/DD-hangolás-2.jpg

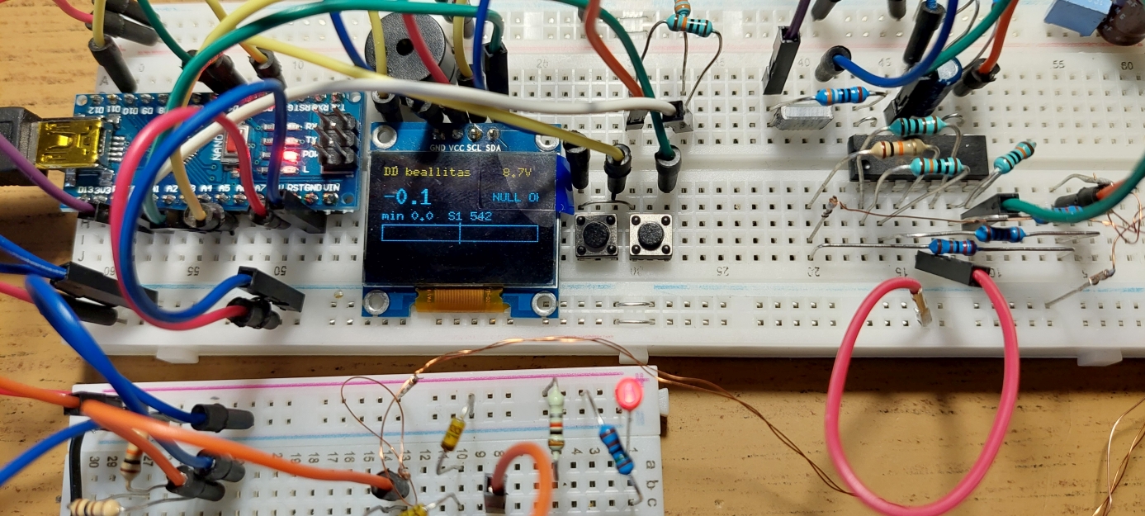
doc/DD-hangolás-2.jpg
