bt-soft/nano-wallscout/doc/drain_csillapitas.png

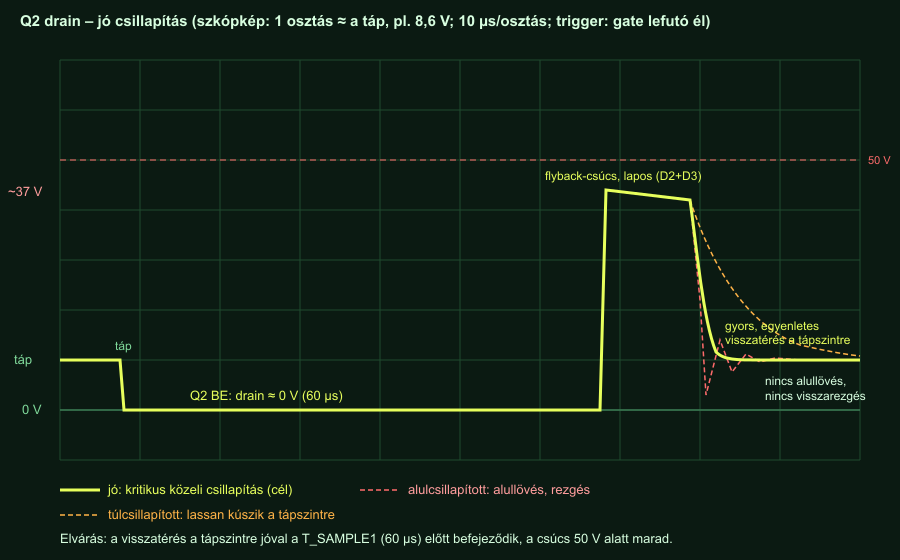
doc/drain_csillapitas.png
