bt-soft/nano-wallscout/doc/Fémkereső tekercsek betonvas kereséshez.png

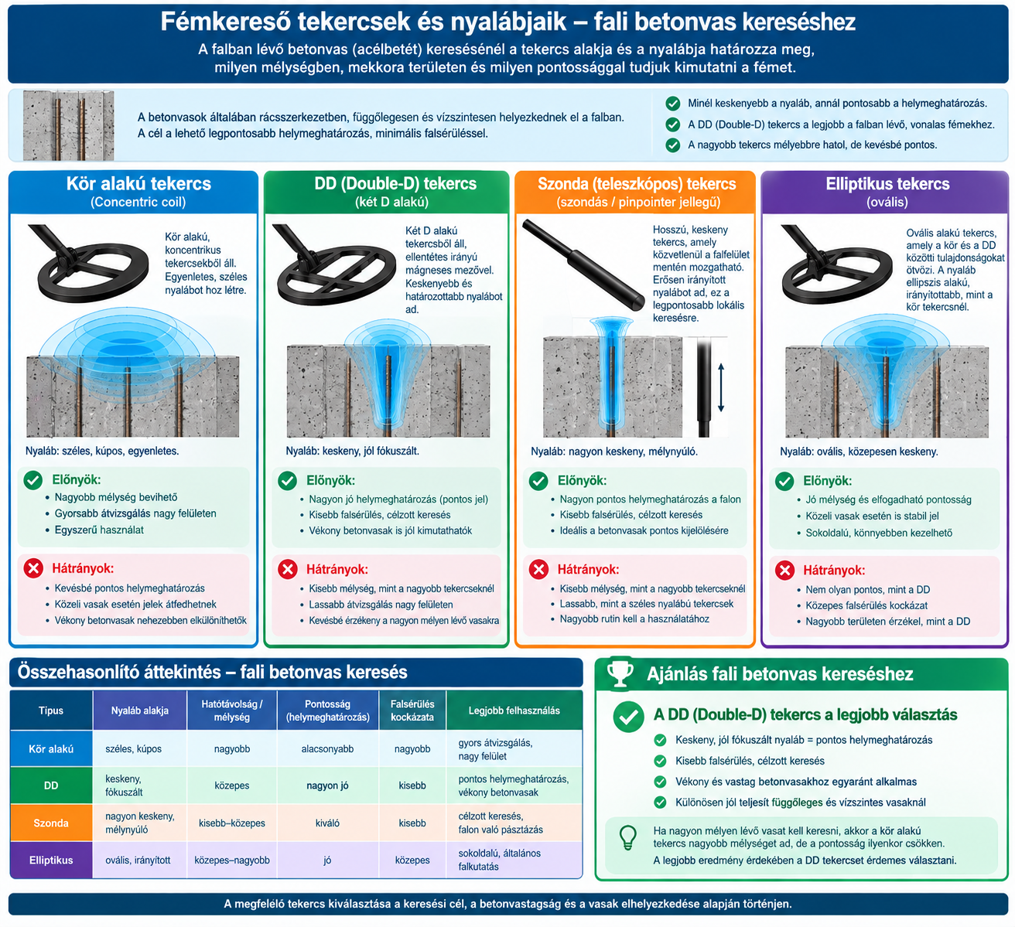
doc/Fémkereső tekercsek betonvas kereséshez.png
