bt-soft/nano-wallscout/doc/Fémkereső tekercsek és nyalábjaik infografika.png

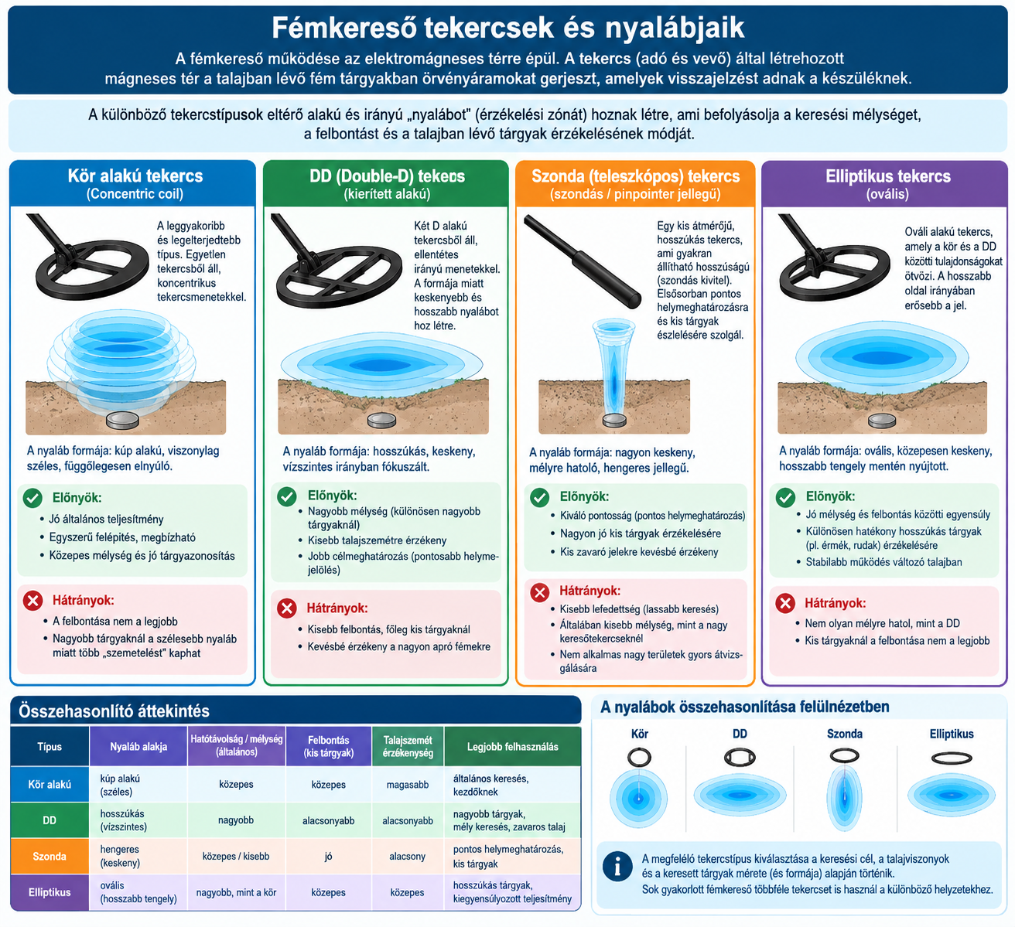
doc/Fémkereső tekercsek és nyalábjaik infografika.png
