bt-soft/nano-wallscout/doc/gate_csomag.png

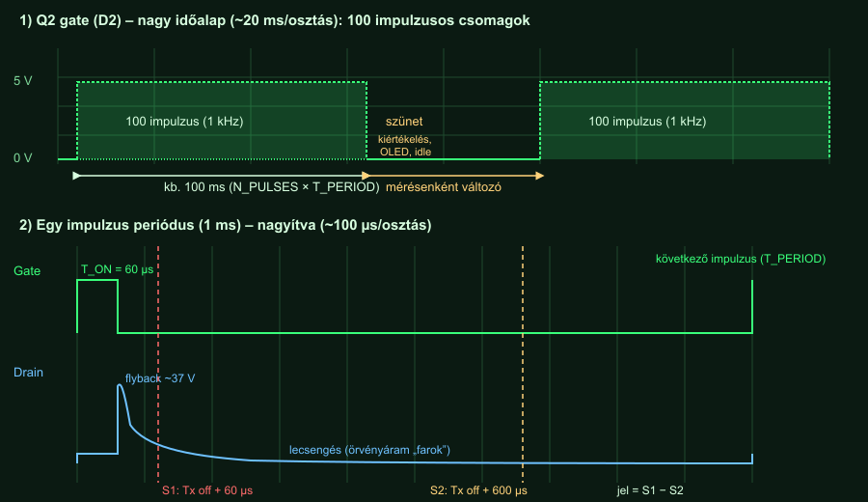
doc/gate_csomag.png
