bt-soft/nano-wallscout/doc/meres_idodiagram.png

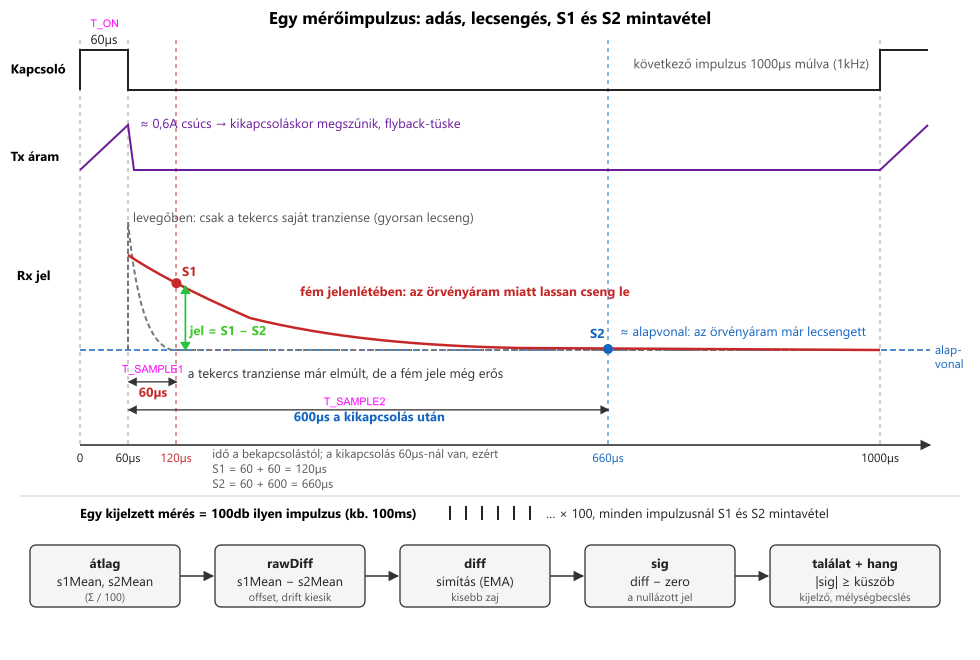
doc/meres_idodiagram.png
