bt-soft/nano-wallscout/doc/PI-lecsengés.jpeg

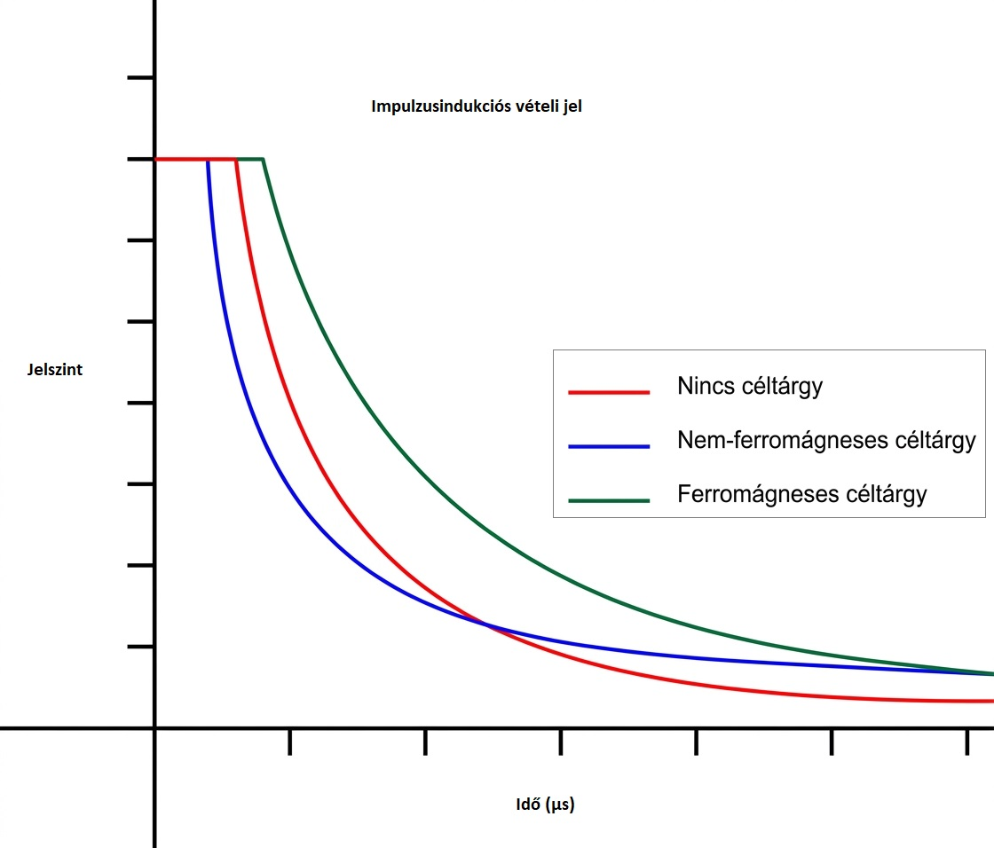
doc/PI-lecsengés.jpeg
