bt-soft/nano-wallscout/doc/tekercs-1-Sablonra.jpg

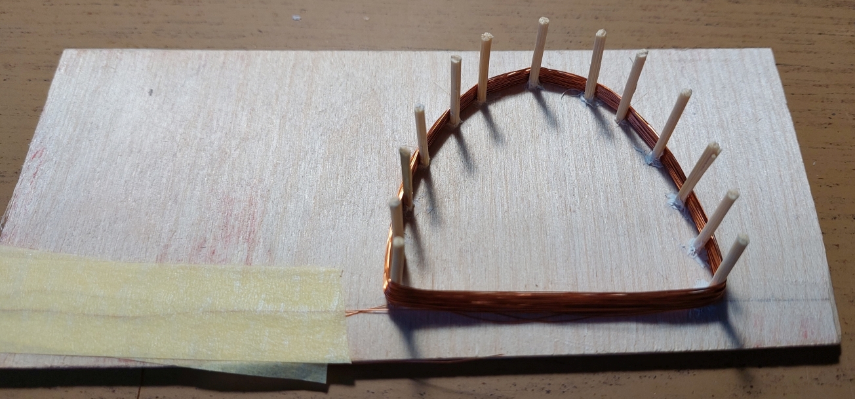
doc/tekercs-1-Sablonra.jpg
