bt-soft/nano-wallscout/doc/tekercs-2-Átmeneti_bandázs.jpg

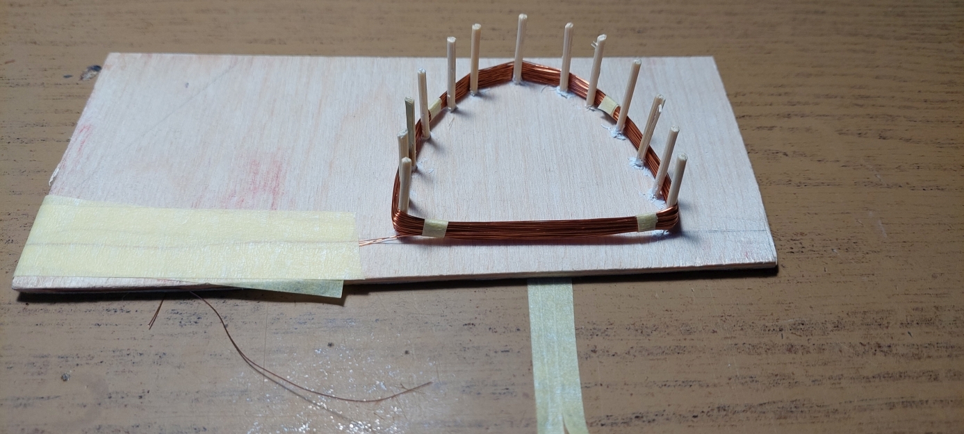
doc/tekercs-2-Átmeneti_bandázs.jpg
