bt-soft/nano-wallscout/doc/tekercs-3-Sablonról_leszedve.jpg

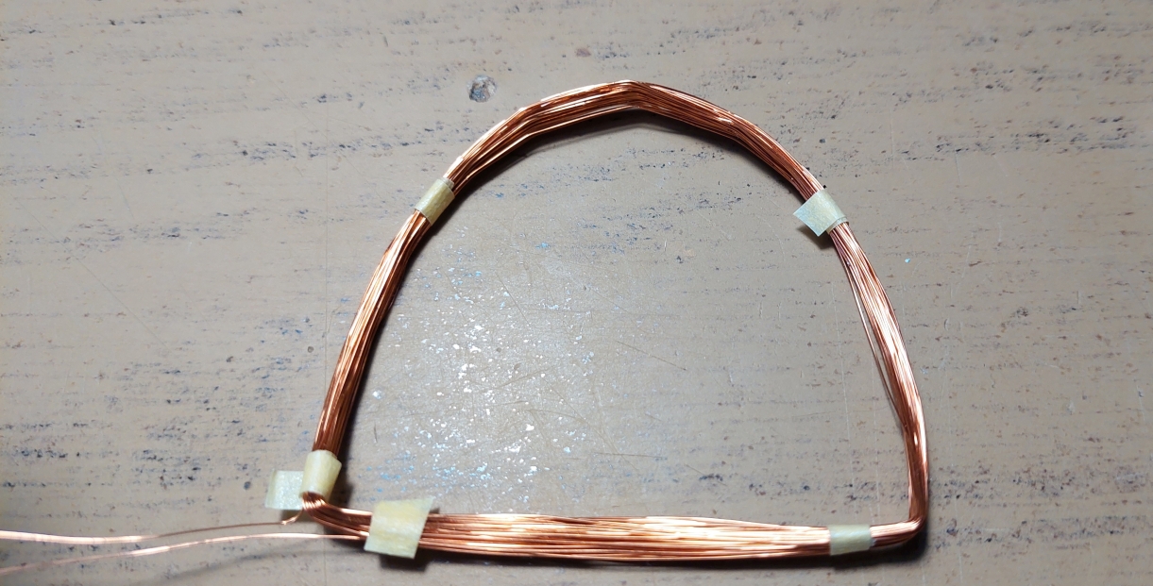
doc/tekercs-3-Sablonról_leszedve.jpg
