bt-soft/nano-wallscout/doc/tekercs-4-TeflonSzalag.jpg

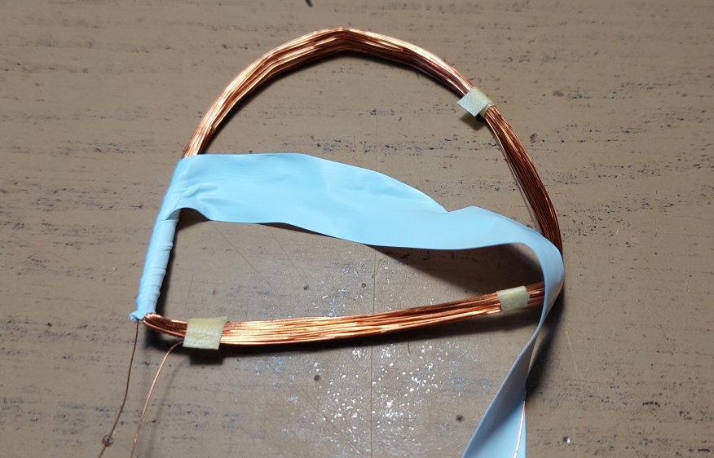
doc/tekercs-4-TeflonSzalag.jpg
