bt-soft/nano-wallscout/doc/tekercs-5-1-Árnyékolás.jpg

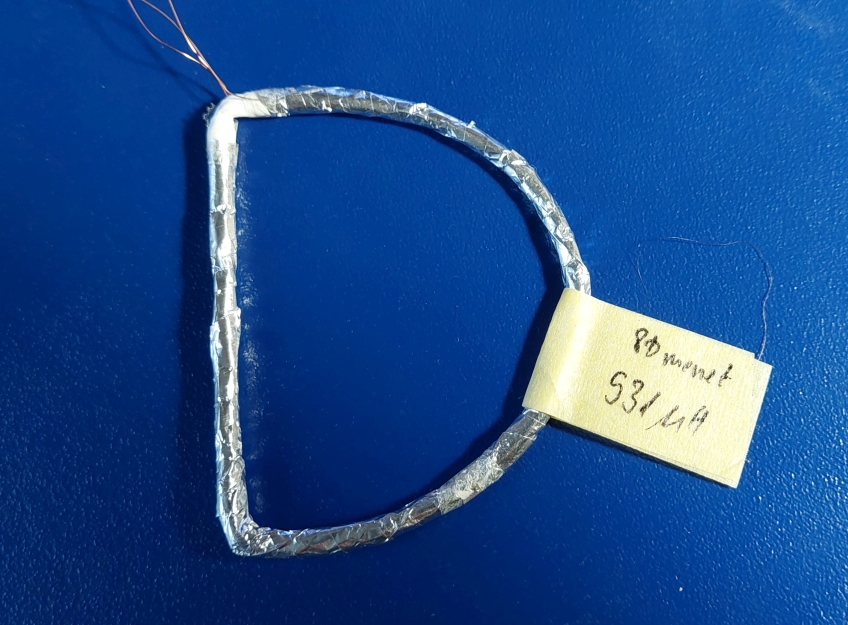
doc/tekercs-5-1-Árnyékolás.jpg
