bt-soft/nano-wallscout/doc/tekercs-5-2-Árnyékolás_hézag.jpg

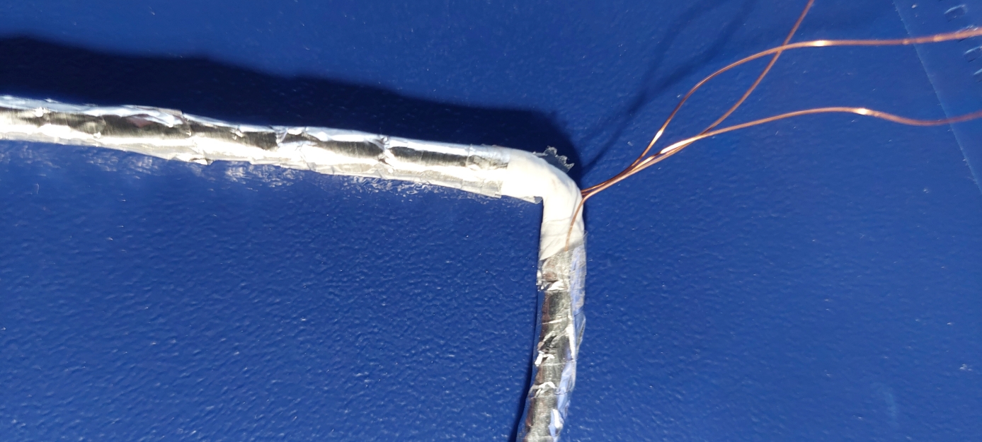
doc/tekercs-5-2-Árnyékolás_hézag.jpg
