bt-soft/nano-wallscout/doc/tekercs-sablon-kicsi.jpg

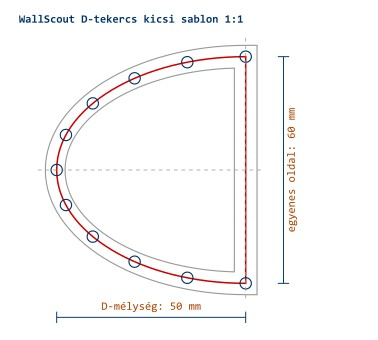
doc/tekercs-sablon-kicsi.jpg
