bt-soft/nano-wallscout/doc/tekercs-sablon-nagy.jpg

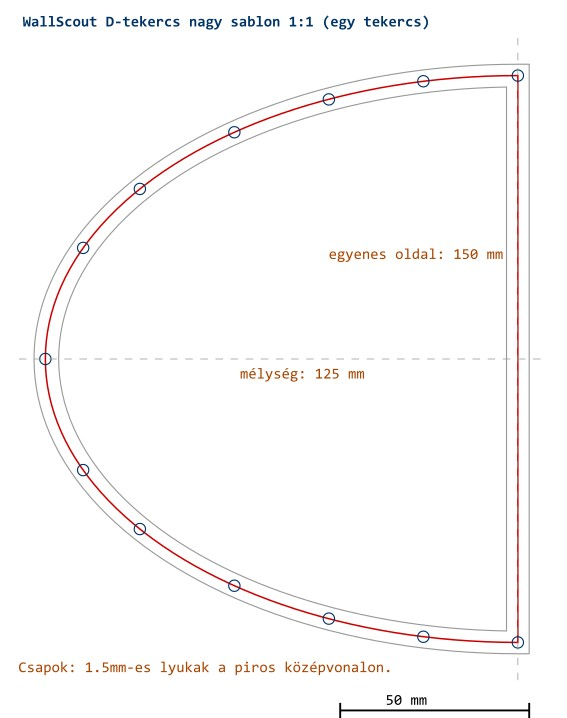
doc/tekercs-sablon-nagy.jpg
