bt-soft/nano-wallscout/doc/Tekercs-váz-1.jpg

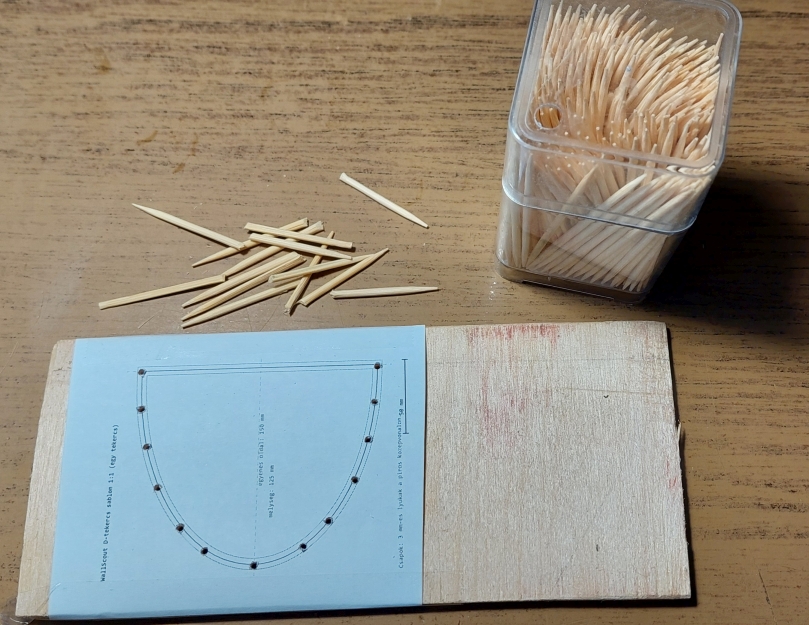
doc/Tekercs-váz-1.jpg
