bt-soft/nano-wallscout/doc/Tekercs-váz-2.jpg

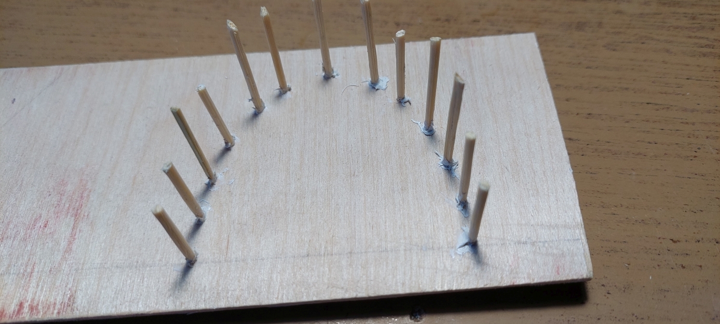
doc/Tekercs-váz-2.jpg
