bt-soft/nano-wallscout/kicad/nano-wallscout-Atmega328P/nano-wallscout-Atmega328P-pcb-3D.png

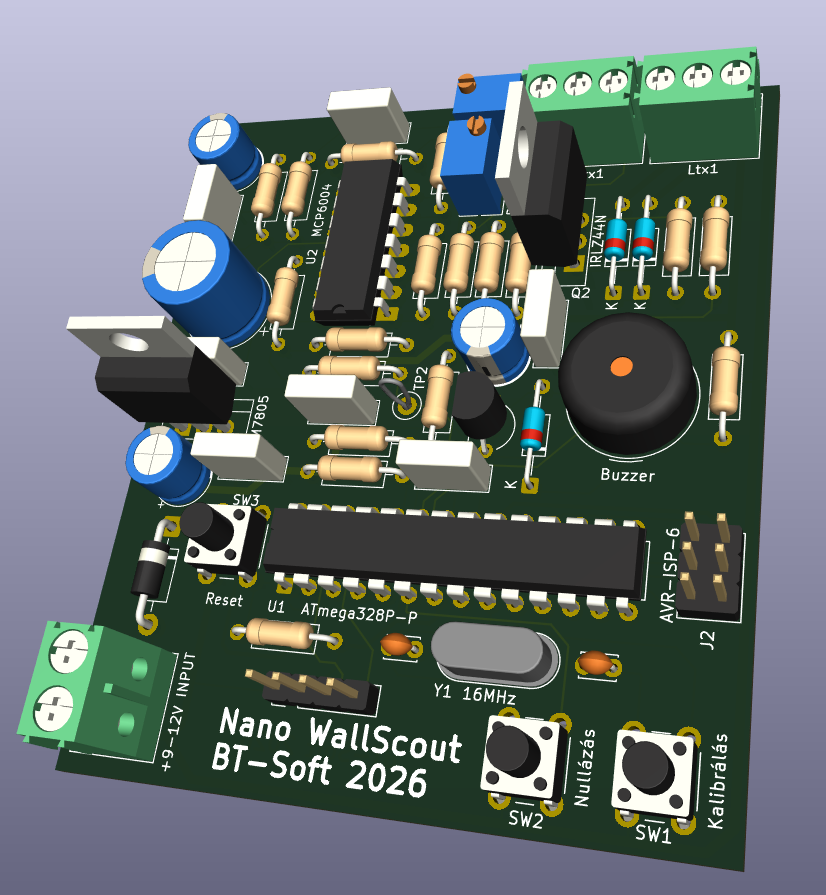
kicad/nano-wallscout-Atmega328P/nano-wallscout-Atmega328P-pcb-3D.png
