bt-soft/nano-wallscout/kicad/nano-wallscout-Atmega328P/nano-wallscout-Atmega328P.kicad_pcb

## KiCad design kicad/nano-wallscout-Atmega328P/nano-wallscout-Atmega328P.kicad_pcb (2026-11-01)

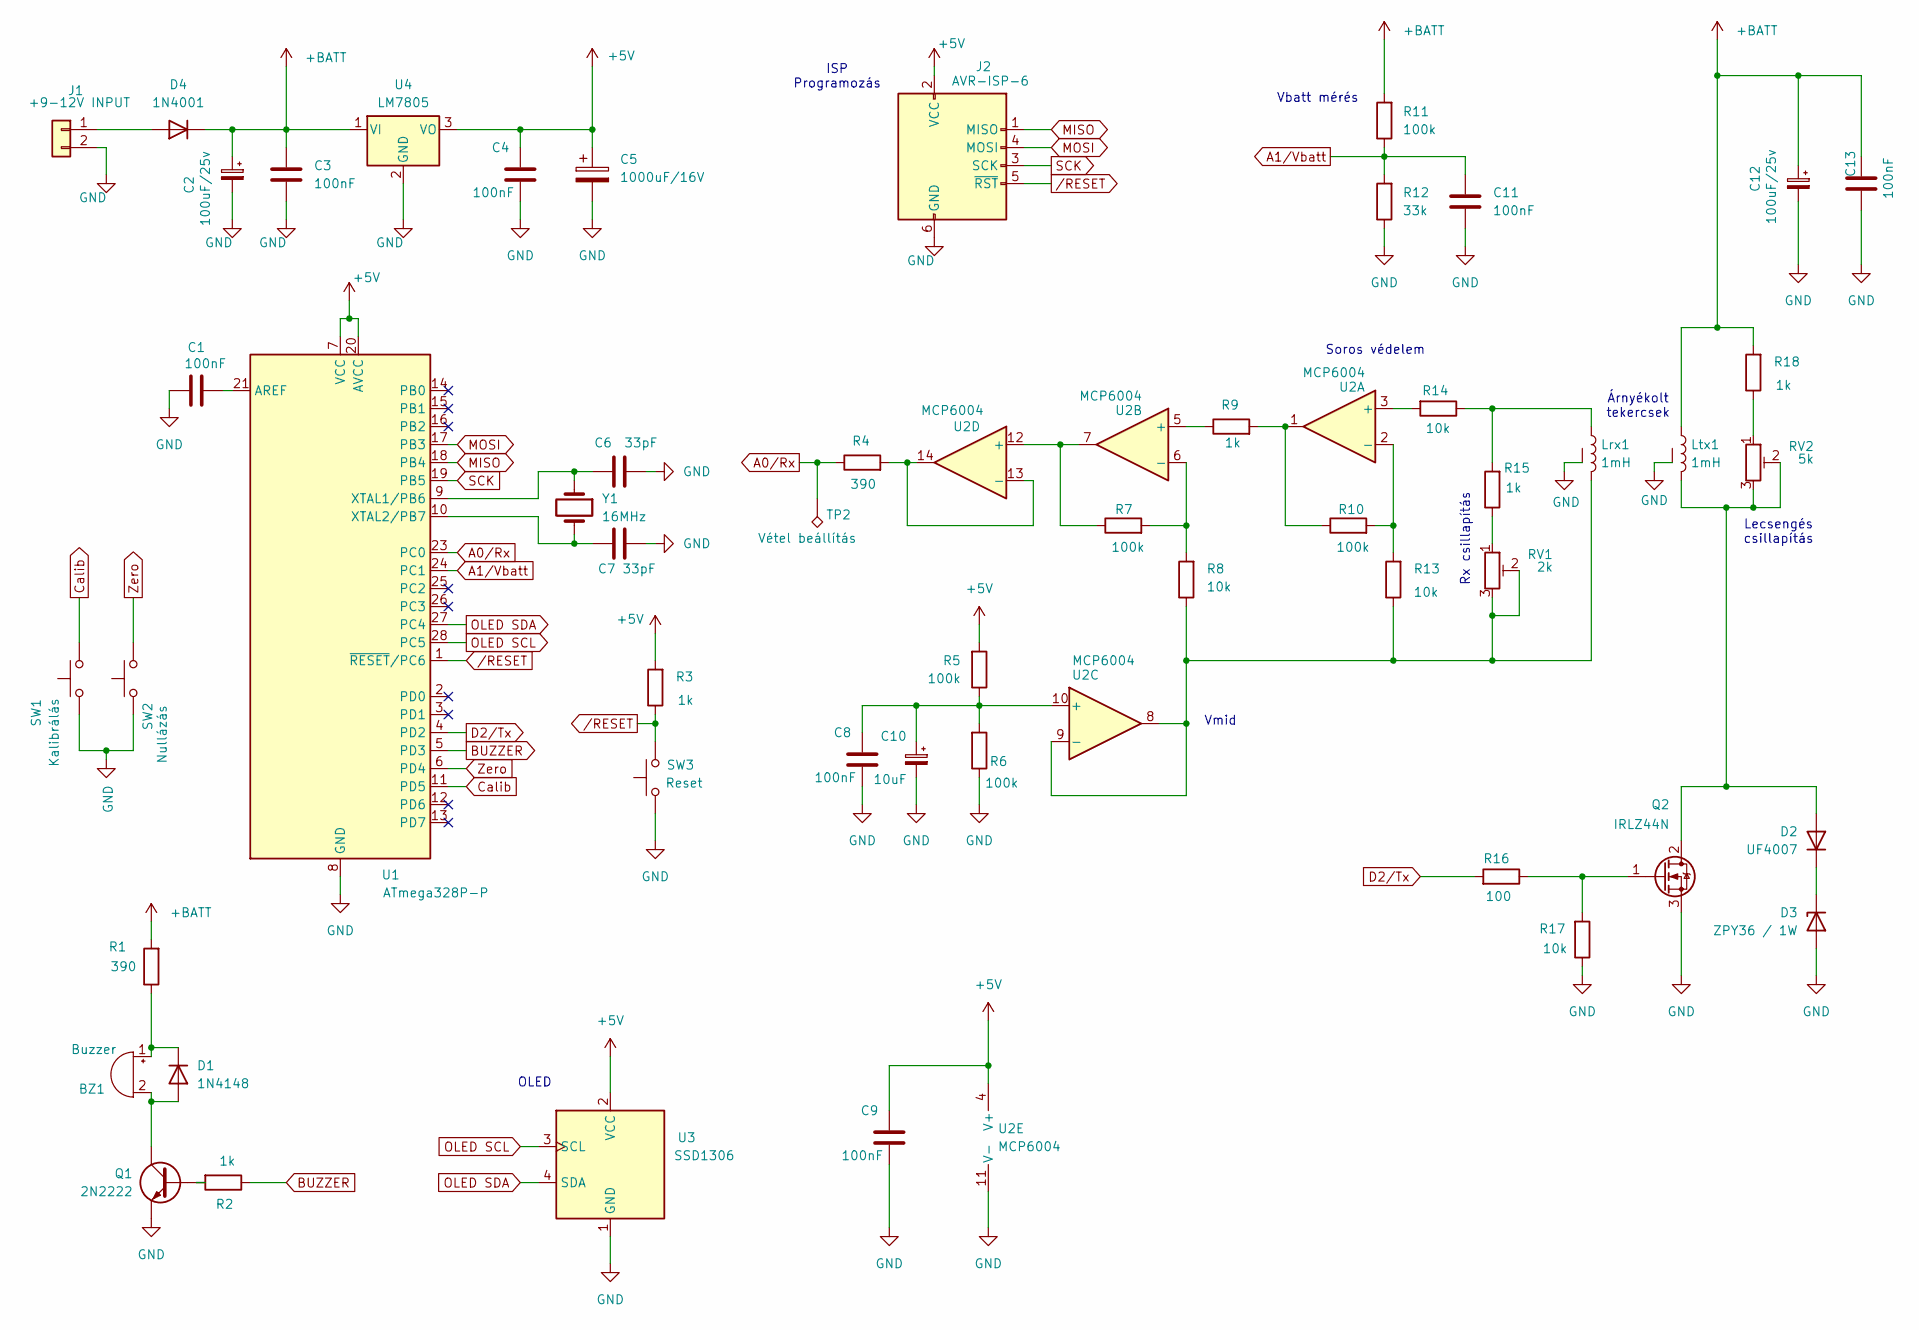
[picture p26: schematic nano-wallscout-Atmega328P.kicad_sch, Arduino Atmel328P betonvas kereső]

Parts:
BZ1: Buzzer; Buzzer_TDK_PS1240P02BT_D12.2mm_H6.5mm
C1, C3, C4, C8, C9, C11, C13: 100nF; C_Rect_L7.2mm_W2.5mm_P5.00mm
C2, C12: 100uF/25v; CP_Radial_D6.3mm_P2.50mm
C5: 1000uF/16V; CP_Radial_D10.0mm_P5.00mm
C6, C7: 33pF; C_Disc_D3.0mm_W2.0mm_P2.50mm
C10: 10uF; CP_Radial_D6.3mm_P2.50mm
D1: 1N4148; D_DO-35_SOD27_P10.16mm_Horizontal
D2: UF4007; D_DO-35_SOD27_P10.16mm_Horizontal
D3: ZPY36 / 1W; D_DO-35_SOD27_P10.16mm_Horizontal
D4: 1N4001; D_DO-41_SOD81_P10.16mm_Horizontal
J1: +9-12V INPUT; TerminalBlock_Phoenix_PT-1,5-2-5.0-H_1x02_P5.00mm_Horizontal
J2: AVR-ISP-6; PinHeader_2x03_P2.54mm_Vertical
Lrx1: 1mH; TerminalBlock_Phoenix_PT-1,5-3-3.5-H_1x03_P3.50mm_Horizontal
Ltx1: 1mH; TerminalBlock_Phoenix_PT-1,5-3-3.5-H_1x03_P3.50mm_Horizontal
Q1: 2N2222; TO-92_Inline_Wide
Q2: IRLZ44N; TO-220-3_Vertical
R1, R4: 390; R_Axial_DIN0207_L6.3mm_D2.5mm_P10.16mm_Horizontal
R2, R3, R9, R15, R18: 1k; R_Axial_DIN0207_L6.3mm_D2.5mm_P10.16mm_Horizontal
R5, R6, R7, R10, R11: 100k; R_Axial_DIN0207_L6.3mm_D2.5mm_P10.16mm_Horizontal
R8, R13, R14, R17: 10k; R_Axial_DIN0207_L6.3mm_D2.5mm_P10.16mm_Horizontal
R12: 33k; R_Axial_DIN0207_L6.3mm_D2.5mm_P10.16mm_Horizontal
R16: 100; R_Axial_DIN0207_L6.3mm_D2.5mm_P10.16mm_Horizontal
RV1: 2k; Potentiometer_Bourns_3266Y_Vertical
RV2: 5k; Potentiometer_Bourns_3266Y_Vertical
SW1: Kalibrálás; SW_PUSH_6mm_H8mm
SW2: Nullázás; SW_PUSH_6mm_H8mm
SW3: Reset; SW_PUSH_6mm_H8mm
TP2: Vétel beállítás; TestPoint_Loop_D2.50mm_Drill1.0mm
U1: ATmega328P-P; DIP-28_W7.62mm
U2: MCP6004; DIP-14_W7.62mm_LongPads
U3: SSD1306; PinHeader_1x04_P2.54mm_Vertical
U4: LM7805; TO-220-3_Vertical
Y1: 16MHz; Crystal_HC49-4H_Vertical

Connections:
+5V: C4.2, C5.1, C9.2, J2.2 (VCC), R3.2, R5.2, U1.7 (VCC), U1.20 (AVCC), U2.4 (V+), U3.2 (VCC), U4.3 (VO)
+BATT: C2.1, C3.1, C12.1, C13.2, D4.1 (K), Ltx1.1, R1.2, R11.2, R18.2, U4.1 (VI)
A0/Rx: R4.1, TP2.1 (1_1), U1.23 (PC0)
A1/Vbatt: C11.1, R11.1, R12.2, U1.24 (PC1)
BUZZER: R2.1, U1.5 (PD3)
Calib: SW1.2, U1.11 (PD5)
D2/Tx: R16.2, U1.4 (PD2)
GND: C1.2, C2.2, C3.2, C4.1, C5.2, C6.1, C7.1, C8.1, C9.1, C10.2, C11.2, C12.2, C13.1, D3.2 (A), J1.2, J2.6 (GND), Lrx1.3 (SHIELD), Ltx1.3 (SHIELD), Q1.3 (E), Q2.3 (S), R6.1, R12.1, R17.1, SW1.1, SW2.1, SW3.1, U1.8 (GND), U1.22 (GND), U2.11 (V-), U3.1 (GND), U4.2 (GND)
MISO: J2.1 (MISO), U1.18 (PB4)
MOSI: J2.4 (MOSI), U1.17 (PB3)
unnamed: BZ1.1 (+), D1.1 (K), R1.1
unnamed: BZ1.2 (-), D1.2 (A), Q1.1 (C)
unnamed: D2.2 (A), Ltx1.2, Q2.2 (D), RV2.2, RV2.3
unnamed: D2.1 (K), D3.1 (K)
unnamed: D4.2 (A), J1.1
unnamed: Lrx1.1, R14.1, R15.2
unnamed: Q1.2 (B), R2.2
unnamed: Q2.1 (G), R16.1, R17.2
unnamed: R9.2, R10.1, U2.1
unnamed: R15.1, RV1.1
unnamed: R18.1, RV2.1
unnamed: C1.1, U1.21 (AREF)
unnamed: C6.2, U1.9 (XTAL1/PB6), Y1.1
unnamed: C7.2, U1.10 (XTAL2/PB7), Y1.2
unnamed: R14.2, U2.3 (+)
unnamed: R10.2, R13.2, U2.2 (-)
unnamed: R9.1, U2.5 (+)
unnamed: R7.2, R8.2, U2.6 (-)
unnamed: C8.2, C10.1, R5.1, R6.2, U2.10 (+)
unnamed: Lrx1.2, R8.1, R13.1, RV1.2, RV1.3, U2.8, U2.9 (-)
unnamed: R7.1, U2.7, U2.12 (+)
unnamed: R4.2, U2.13 (-), U2.14
OLED SCL: U1.28 (PC5), U3.3 (SCL)
OLED SDA: U1.27 (PC4), U3.4 (SDA)
SCK: J2.3 (SCK), U1.19 (PB5)
Zero: SW2.2, U1.6 (PD4)
/RESET: J2.5 (~RST), R3.1, SW3.2, U1.1 (~RESET/PC6)

Notes on the sheet:
Lecsengés csillapítás
Vmid
Árnyékolt tekercsek
Rx csillapítás
Vbatt mérés
ISP Programozás
OLED
Soros védelem

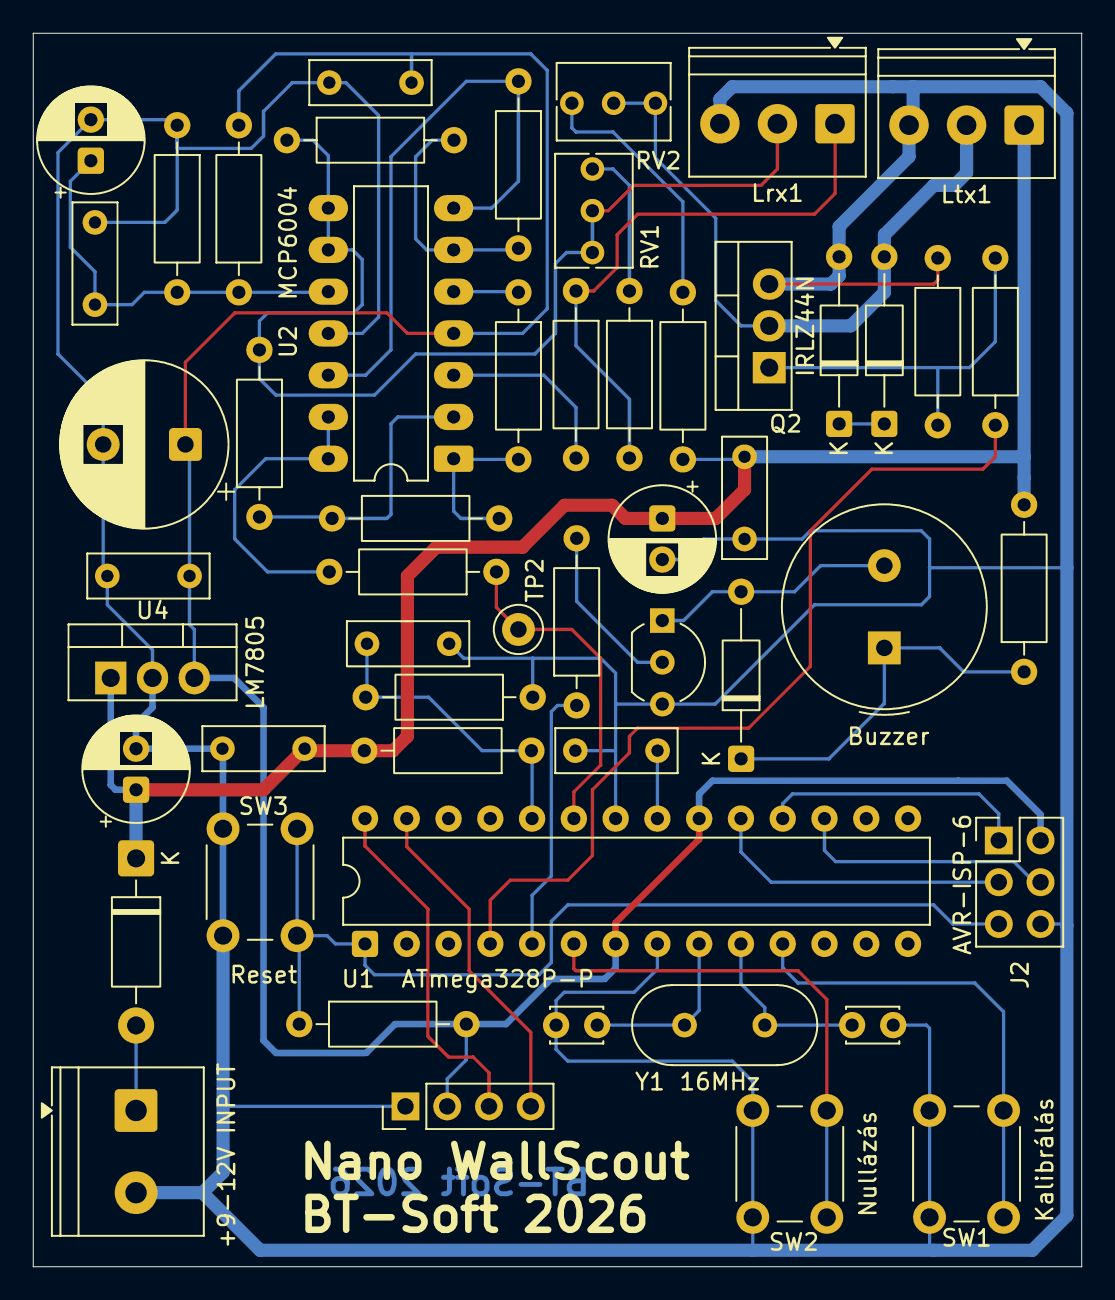
[picture p27: board nano-wallscout-Atmega328P.kicad_pcb from above]

Board: 2 copper layers, 63.8 x 75.0 mm, 53 parts (0 on the bottom side), 37 nets.
