bt-soft/nano-wallscout/include/config.h

/**
 * @file A betonvas-kereső közös hardveres és mérési beállításai.
 */
#pragma once

#include <Arduino.h>

/**
 * @brief Engedélyezi a soros naplózást és a hibakeresést.
 *
 *  A Soros naplózás és az AVR8-stub hibakeresés együtt nem használható!!
 *  https://docs.platformio.org/en/stable/plus/debug-tools/avr-stub.html
 */
// #define __DEBUG__

/**
 * @brief Középkereső képernyő fordítása
 *
 * Ezt kikapcsolva a kód nem kerül a firmware-be
 */
// #define ENABLE_CENTER_FINDER_SCREEN

/**
 * @brief Az Arduino Nano lábkiosztása a kapcsolási rajz szerint.
 *
 * D4: kalibrálógomb;
 * D5: nullázó- és DD-beállítógomb;
 * D2: Q2 FET kapuja.
 * D3: hangjelző;
 * A0: mérőjel;
 * A1: akkumulátorfeszültség-osztó.
 * A4 és A5: OLED I²C-kapcsolat.
 */
#define GATE_BIT PD2     // Q2 FET Gate lábának bitje a PORTD regiszterben
#define PIN_BUZZER PD3   // Hangjelző lábának bitje a PORTD regiszterben
#define PIN_BTN_CAL PD4  // Kalibrálógomb lába
#define PIN_BTN_ZERO PD5 // Nullázó- és DD-beállítógomb lába

/** @brief A Q2 FET bekapcsolási ideje mikroszekundumban. */
static const uint16_t T_ON = 60;

/** @brief Az impulzusok periódusideje mikroszekundumban. */
static const uint16_t T_PERIOD = 1000;

/** @brief Az első minta időpontja a Q2 FET kikapcsolása után, mikroszekundumban. */
static const uint16_t T_SAMPLE1 = 60;

/** @brief A referencia-minta időpontja a Q2 FET kikapcsolása után,
 * mikroszekundumban. */
static const uint16_t T_SAMPLE2 = 600;

/** @brief A DD-csatolás mintavételi időpontja a Q2 bekapcsolása után,  mikroszekundumban. */
static const uint16_t T_COUPLE = 40;

/** @brief Az egy méréshez átlagolt impulzusok száma. */
static const uint16_t N_PULSES = 100;

/** @brief A Timer1 időzítőütéseinek száma mikroszekundumonként. */
static const uint16_t TICKS_PER_US = 2;

/** @brief A találat érzékelési küszöbe ADC-egységben. */
static const float DETECT_TH = 1.3f;

/** @brief A találat kikapcsolási küszöbe a bekapcsolási küszöb (`runTh`) arányában; ez adja a hiszterézist. */
static const float DETECT_RELEASE_FRACTION = 0.6f;

/** @brief A nullázáskor mért zaj szórásának szorzója az adaptív küszöbhöz (`runTh`). */
static const float NOISE_TH_FACTOR = 5.0f;

/** @brief A kalibrálás nélküli teljes kijelzőskálához tartozó jel. */
static const float FULL_SCALE = 60.0f;

/** @brief A DD-beállítás logaritmikus skálájának teljes értéke. */
static const float SETUP_FULL = 500.0f;

/** @brief A kalibráláshoz használt ismert mélység centiméterben. */
static const float CAL_DEPTH_CM = 5.0f;

/** @brief Az akkumulátor feszültségosztójának aránya. (100k + 33k) / 33k */
static const float BATT_DIV = (100.0f + 33.0f) / 33.0f;

/** @brief Az indulási nullázáshoz szükséges mérési ciklusok száma. */
static const uint16_t ZERO_UPDATES = 15;

/** @brief A hosszú gombnyomás küszöbideje milliszekundumban. */
static const uint32_t LONG_PRESS_MS = 1000;

/** @brief A nullpont lassú követésének súlya küszöb alatti jelnél. */
static const float DRIFT_FOLLOW = 0.02f;

/** @brief Ennyi egymást követő küszöb feletti mérés kell a jelölt megerősítéséhez. */
static const uint8_t CENTER_CONFIRM_SAMPLES = 2;

/** @brief Ennyi csökkenő mérés kell egy lehetséges csúcshoz. */
static const uint8_t CENTER_FALLING_SAMPLES = 3;

/** @brief Időtúllépés a csúcskövetési és a visszapásztázási szakaszra milliszekundumban. */
static const uint32_t CENTER_STAGE_TIMEOUT_MS = 20000;

/** @brief A keresési küszöb alatti visszaesés aránya a jelölt törléséhez. */
static const float CENTER_RELEASE_FRACTION = 0.70f;

/** @brief A csúcstól elvárt minimális visszaesés aránya a zajküszöbhöz képest. */
static const float CENTER_PEAK_HYSTERESIS_FRACTION = 0.20f;

/** @brief A visszapásztázás előtt szükséges minimális jelcsökkenés az első csúcshoz képest. */
static const float CENTER_MIN_RETURN_DROP_FRACTION = 0.30f;

/** @brief A két pásztázás csúcserőssége közötti megengedett relatív eltérés. */
static const float CENTER_RETURN_TOLERANCE_FRACTION = 0.35f;

/** @brief A visszatérő csúcs minimális abszolút eltéréstűrése a becsült zajküszöb többszörösében. */
static const float CENTER_RETURN_MIN_TOLERANCE = 2.0f;

/** @brief E feletti adaptív küszöbnél a középkereső zajos mérést jelez. Hangolása valós mérést igényel. */
static const float CENTER_NOISY_THRESHOLD = 8.0f;

/** @brief A Jel-Ido nézet gördülő jelgrafikonjának rögzített mintaszáma. */
static const uint8_t SIGNAL_TIME_GRAPH_SIZE = 32;

/** @brief Az exponenciális simítás súlya normál üzemmódban. A kisebb érték lassabban követi a jelváltozásokat. */
static const float SMOOTH_RUN = 0.5f;

/** @brief Az exponenciális simítás súlya DD-beállító módban. A kisebb érték lassabban követi a jelváltozásokat. */
static const float SMOOTH_SETUP = 0.1f;

/** @brief Ennél nagyobb ugrásnál a simítás új értékről indul. */
static const float SMOOTH_JUMP = 60.0f;

/** @brief A túlvezérlés felső ADC-küszöbe. */
static const float OVERLOAD_HIGH = 950.0f;

/** @brief A túlvezérlés alsó ADC-küszöbe. */
static const float OVERLOAD_LOW = 70.0f;

/** @brief A DC-hiba felső ADC-küszöbe. */
static const uint16_t IDLE_HIGH = 900;

/** @brief A DC-hiba alsó ADC-küszöbe. */
static const uint16_t IDLE_LOW = 120;

/**
 * @brief A mérőjel ADC-csatornája; a beállító mód is ezt a jelutat használja.
 */
static const uint8_t CHANNEL = 0;

/**
 * @brief Bekapcsolja vagy kikapcsolja a hardveres watchdog használatát.
 *
 * A watchdog a rendszer lefagyása esetén újraindítja a kütyüt.
 */
#define USE_WATCHDOG 1

/** Ennyi inaktivitás (ms) után a kütyü alvó módba kapcsol  */
#define IDLE_SLEEP_MS (1000UL * 60UL * 5UL) // 5 perc
