bt-soft/nano-wallscout/(commit log)

2026-10-23 Add SVG templates for WallScout D-tekercs and hardware schematic
    - Created coil_sablon.svg for a 1:1 template of the D-tekercs with dimensions and markings.
    - Added coil_sablon_60x50.svg for a 1:1 template of a 60 mm straight section with 50 mm depth.
    - Introduced hardware.svg detailing the induction balance (IB) circuit schematic for the WallScout project.
    - Added platformio.ini for PlatformIO project configuration targeting Arduino Nano.
    - Implemented main.cpp for the WallScout detection logic, including RX/TX handling, calibration, and user interface.
2026-10-24 Add SVG generation script for circuit diagrams
    - Implemented a new Python script `gen.py` to generate SVG diagrams for electronic circuits.
    - Introduced a `Sheet` class to handle drawing operations including wires, lines, dots, text, and various components (resistors, capacitors, MOSFETs, etc.).
    - Created functions for specific circuit sheets, detailing connections and components for a power supply, analog signal path, and Raspberry Pi Pico connections.
    - Enhanced visual representation with customizable colors and styles for different circuit elements.
2026-10-24 Add SVG diagram for Arduino Nano wiring (3/3)
2026-10-25 Add beeper, calibration, display, and sensor modules
    - Implemented beeper functionality with PWM control using Timer2.
    - Added calibration routines for depth measurement and EEPROM storage.
    - Created display functions for SSD1306 OLED, including normal and setup modes.
    - Developed sensor module for ADC sampling, button polling, and battery level reading.
    - Configured necessary constants and pin assignments in config.h.
2026-10-25 Add lock file for nano-wallscout project with hostname and username
    [nano-wallscout.kicad_pcb, nano-wallscout.kicad_sch]
2026-10-25 Add SVG diagram explaining flyback clipping: good vs bad scenarios
    [nano-wallscout.kicad_sch]
2026-10-25 Refactor config.h: Improve documentation and adjust constants
    - Enhanced comments for clarity, breaking long lines into multiple lines for better readability.
    - Increased the weight of the exponential smoothing in normal mode from 0.3 to 0.5.
    [nano-wallscout.kicad_sch]
2026-10-29 Atmel328P version, Buzzer on PD3 pin
    [nano-wallscout-Atmega328P.kicad_pcb, nano-wallscout-Atmega328P.kicad_sch, nano-wallscout.kicad_pcb, nano-wallscout.kicad_sch]
2026-10-29 Atmel328P version PCB update
    [nano-wallscout-Atmega328P.kicad_pcb, nano-wallscout-Atmega328P.kicad_sch]
2026-10-29 NYÁK rendelés
    [nano-wallscout-Atmega328P-B_Cu.gbr, nano-wallscout-Atmega328P-B_Mask.gbr, nano-wallscout-Atmega328P-B_Silkscreen.gbr, nano-wallscout-Atmega328P-Edge_Cuts.gbr, nano-wallscout-Atmega328P-F_Cu.gbr, nano-wallscout-Atmega328P-F_Mask.gbr, nano-wallscout-Atmega328P-F_Silkscreen.gbr, nano-wallscout-Atmega328P-NPTH.drl]
2026-10-29 proximity sensing test
    [nano-wallscout-Atmega328P.kicad_sch]
2026-10-30 feat: Implement deep sleep mode and optimize firmware for power efficiency
    - Added deep sleep functionality to reduce power consumption after 5 minutes of inactivity.
    - Introduced displaySleep() function to turn off the OLED display and stop I²C communication.
    - Updated center_finder.cpp to improve state management and added detailed comments for clarity.
    - Enhanced sensor.cpp with better ADC clock settings and comments.
    - Updated README.md with new software operation details and energy-saving features.
    - Added new images and infographics related to metal detector coils for better documentation.
2026-10-30 HandHeld harware SCH+PCB begin
    [nano-wallscout-Atmega328P-handheld.kicad_pcb, nano-wallscout-Atmega328P-handheld.kicad_sch, nano-wallscout-Atmega328P.kicad_sch]
2026-10-30 Refactor display positioning and mute buzzer during measurement
    [display.cpp, main.cpp]
2026-10-31 Refactor main program structure and add new modules
    - Moved measurement and outcome structures to app_types.h for better organization.
    - Introduced SignalGraph structure in signal_graph.h to manage rolling signal graphs.
    - Added serial logging functionality in serial_log.h for debug mode.
    - Simplified main.cpp by breaking down large functions and improving readability.
    - Enhanced button handling logic for better state management.
    - Updated measurement processing to include new graphing functionality.
    - Improved comments and documentation throughout the code for clarity.
2026-10-31 Replace magic number with FLT_MAX for better clarity in calibration logic
    [app_types.h, calibration.cpp, main.cpp]
2026-10-31 Refactor calibration function documentation for clarity and consistency
2026-10-31 Fix documentation for watchdog usage and clarify idle sleep duration comment
    [config.h]
2026-11-01 Refactor code structure and remove redundant sections for improved readability and maintainability
    [nano-wallscout-Atmega328P-handheld.kicad_sch, nano-wallscout-Atmega328P.kicad_pcb, nano-wallscout-Atmega328P.kicad_sch, nano-wallscout.kicad_sch]
2026-11-04 Add SVG diagrams for Q2 gate and Rx signal path analysis
    - Created gate_csomag.svg illustrating the Q2 gate operation with 100 pulse packages and timing details.
    - Added rx_szkop.svg depicting the Rx signal path under various conditions, including air and iron scenarios, with detailed annotations on signal behavior and potential issues.
    [nano-wallscout-Atmega328P.kicad_sch]
